rohamid/lcd-east-rising-backpack/lcd-bar-3_4/doc/lcd-bar-3_4.pdf

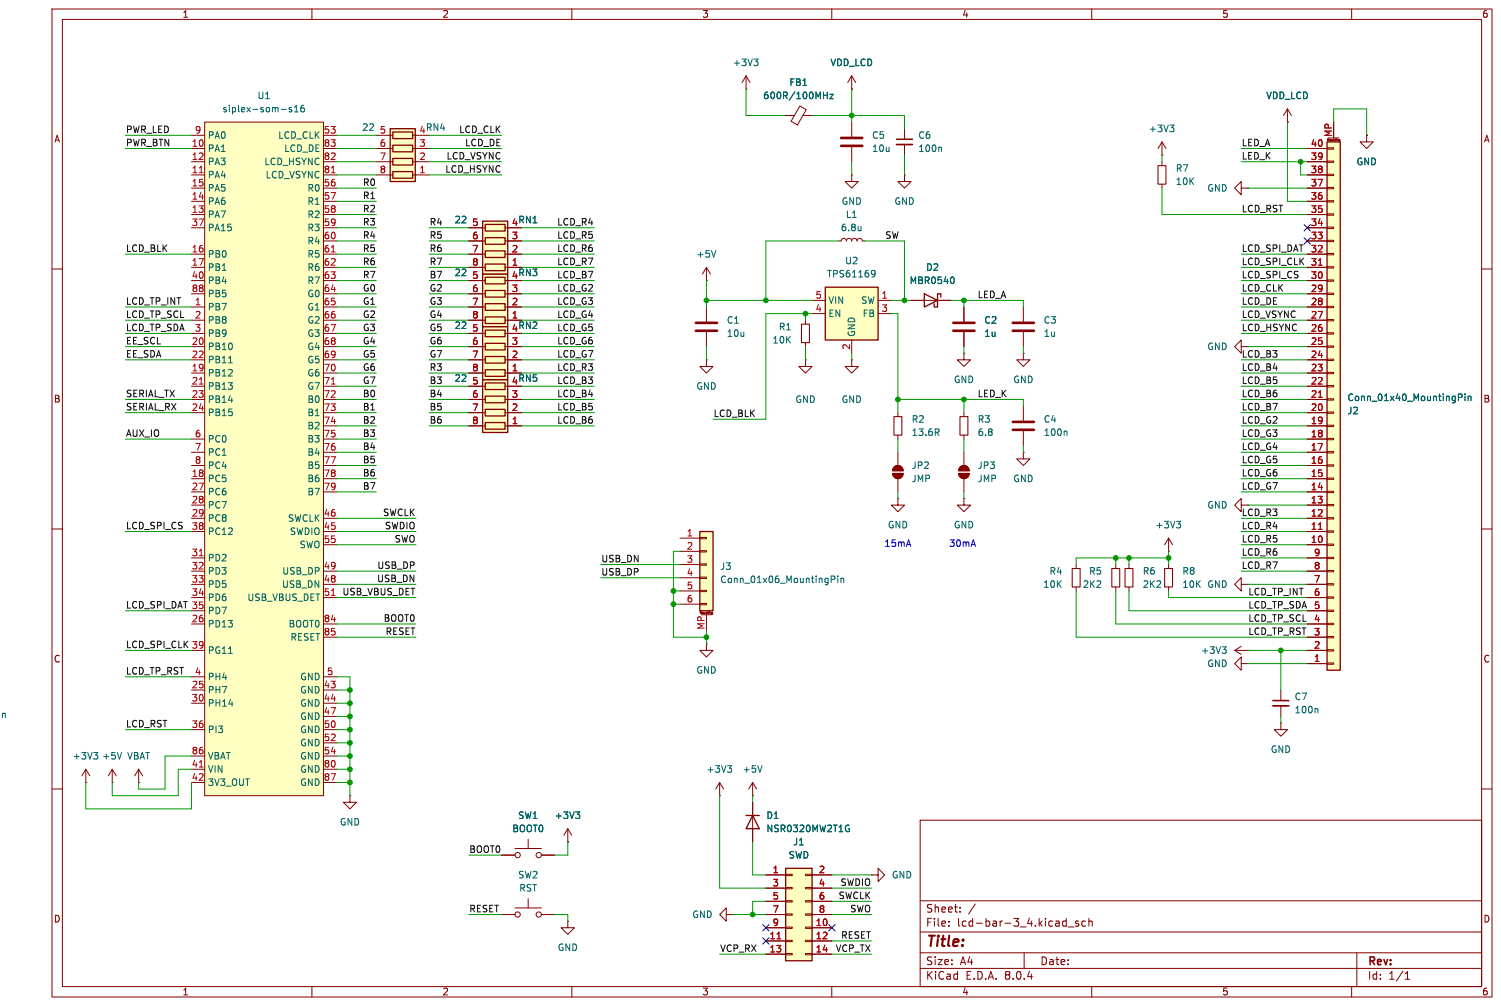
[picture p1: page 1]

Id: 1/1 Title: File: lcd-bar-3_4.kicad_sch Sheet: / D1 NSR0320MW2T1G
