rohamid/lcd-east-rising-backpack/lcd-standard-5R/lcd-standard-5R.kicad_pcb

## KiCad design lcd-standard-5R/lcd-standard-5R.kicad_pcb (2025-04-16)

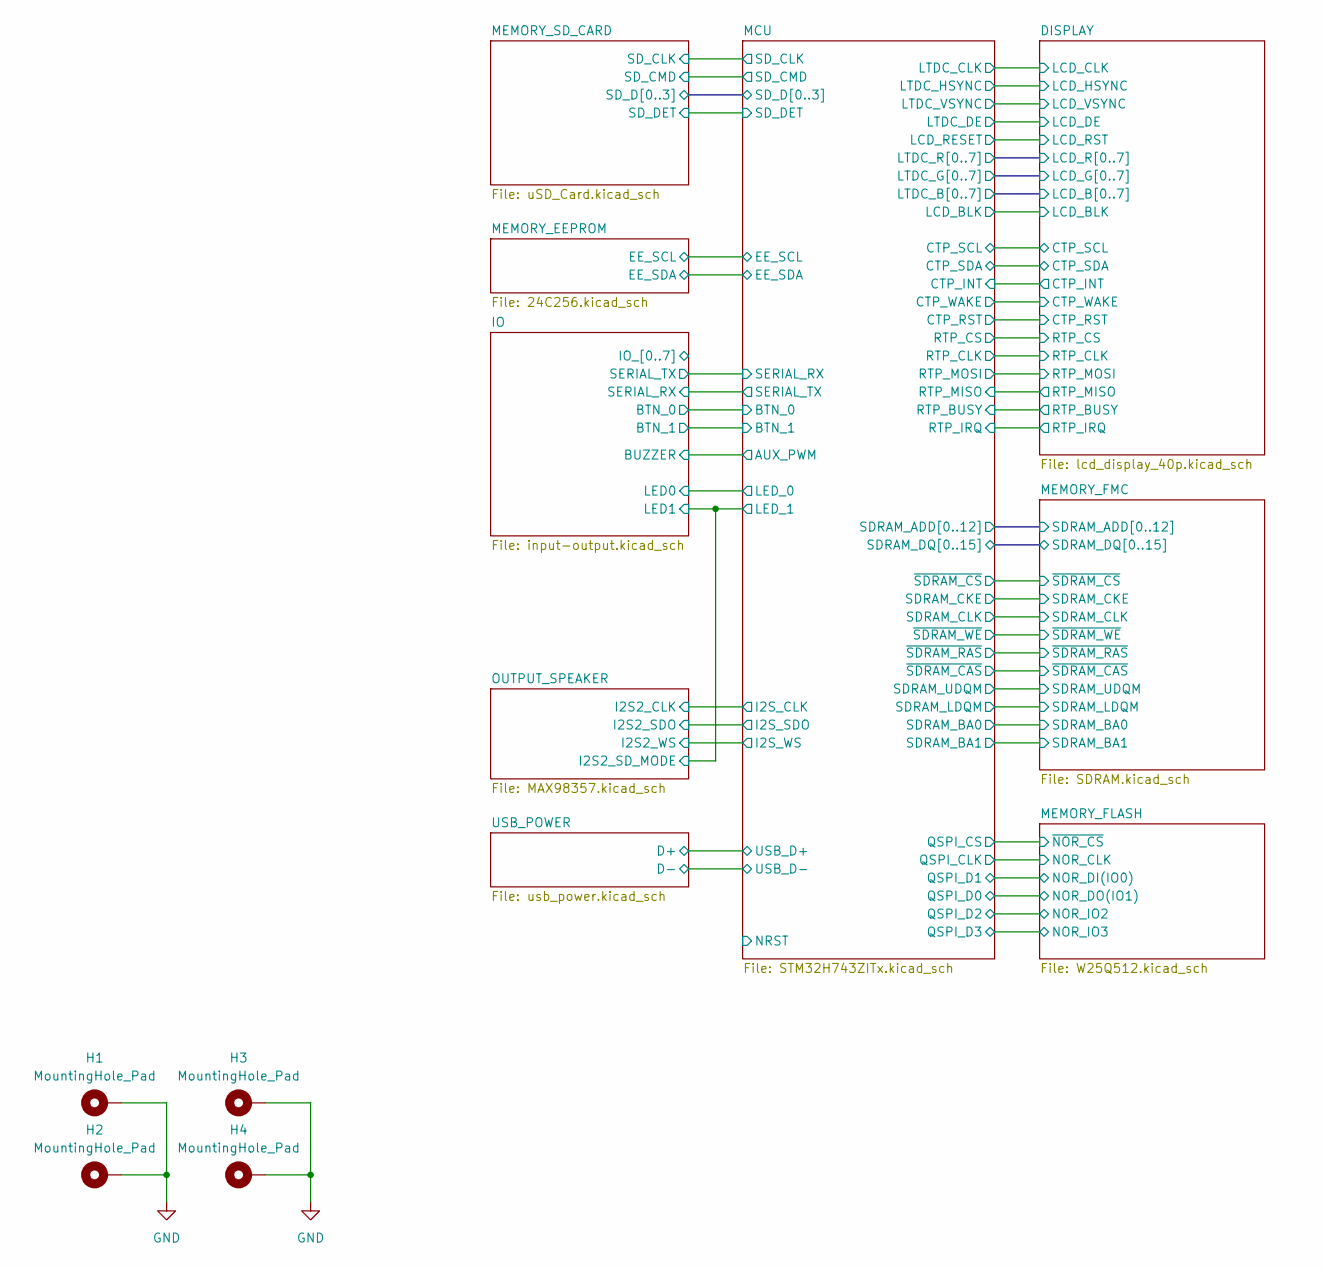
[picture p2: schematic lcd-standard-5R.kicad_sch]

Parts:
H1, H2, H3, H4: MountingHole_Pad; MountingHole_3.2mm_M3_Pad_Via

Connections:
GND: H1.1, H2.1, H3.1, H4.1; also elsewhere on the board

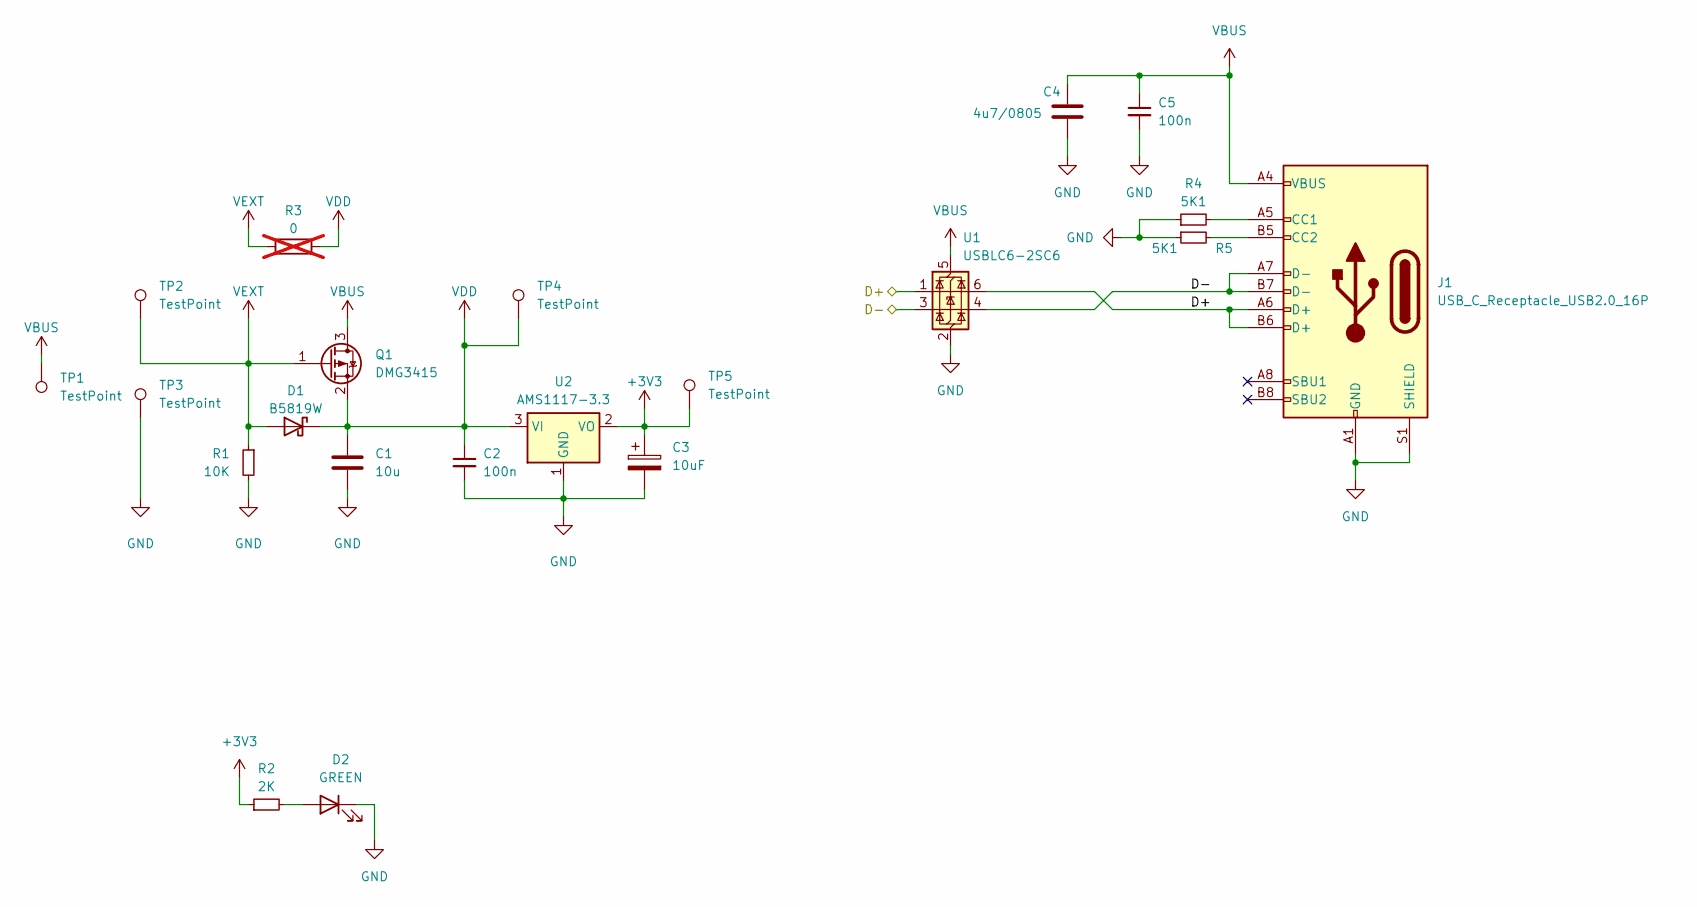
[picture p3: schematic usb_power.kicad_sch]

Parts:
C1: 10u; C_0805_2012Metric; JLCPCB Part # C15850
C2, C5: 100n; C_0402_1005Metric; JLCPCB Part # C307331
C3: 10uF; CP_EIA-3216-18_Kemet-A; JLCPCB Part # C7171
C4: 4u7/0805; C_0805_2012Metric; JLCPCB Part # C1779
D1: B5819W; D_SOD-123; JLCPCB Part # C7420330
D2: GREEN; LED_0805_2012Metric; JLCPCB Part # C2297
J1: USB_C_Receptacle_USB2.0_16P; USB_C_Receptacle_G-Switch_GT-USB-7010ASV; JLCPCB Part # C963412
Q1: DMG3415; SOT-23; JLCPCB Part # C7202986
R1: 10K; R_0402_1005Metric; JLCPCB Part # C25744
R2: 2K; R_0402_1005Metric; JLCPCB Part # C4109
R3: 0; R_1206_3216Metric; not fitted
R4, R5: 5K1; R_0402_1005Metric; JLCPCB Part # C25905
TP1, TP2, TP3, TP4, TP5: TestPoint; TestPoint_Pad_D1.0mm
U1: USBLC6-2SC6; SOT-23-6; JLCPCB Part # C2827654
U2: AMS1117-3.3; SOT-223-3_TabPin2; JLCPCB Part # C6186

Connections:
+3V3: C3.1, R2.1, TP5.1, U2.2 (VO); also elsewhere on the board
/USB_POWER/D+: J1.A6 (D+), J1.B6 (D+), U1.1 (I/O1), U1.6 (I/O1); also elsewhere on the board
/USB_POWER/D-: J1.A7 (D-), J1.B7 (D-), U1.3 (I/O2), U1.4 (I/O2); also elsewhere on the board
GND: C1.2, C2.2, C3.2, C4.2, C5.2, D2.1 (K), J1.A1 (GND), J1.A12 (GND), J1.B1 (GND), J1.B12 (GND), J1.S1 (SHIELD), R1.2, R4.1, R5.1, TP3.1, U1.2 (GND), U2.1 (GND); also elsewhere on the board
unnamed: D2.2 (A), R2.2
unnamed: J1.A5 (CC1), R4.2
unnamed: J1.B5 (CC2), R5.2
VBUS: C4.1, C5.1, J1.A4 (VBUS), J1.A9 (VBUS), J1.B4 (VBUS), J1.B9 (VBUS), Q1.3 (D), TP1.1, U1.5 (VBUS)
VDD: C1.1, C2.1, D1.1 (K), Q1.2 (S), R3.2, TP4.1, U2.3 (VI); also elsewhere on the board
VEXT: D1.2 (A), Q1.1 (G), R1.1, R3.1, TP2.1; also elsewhere on the board

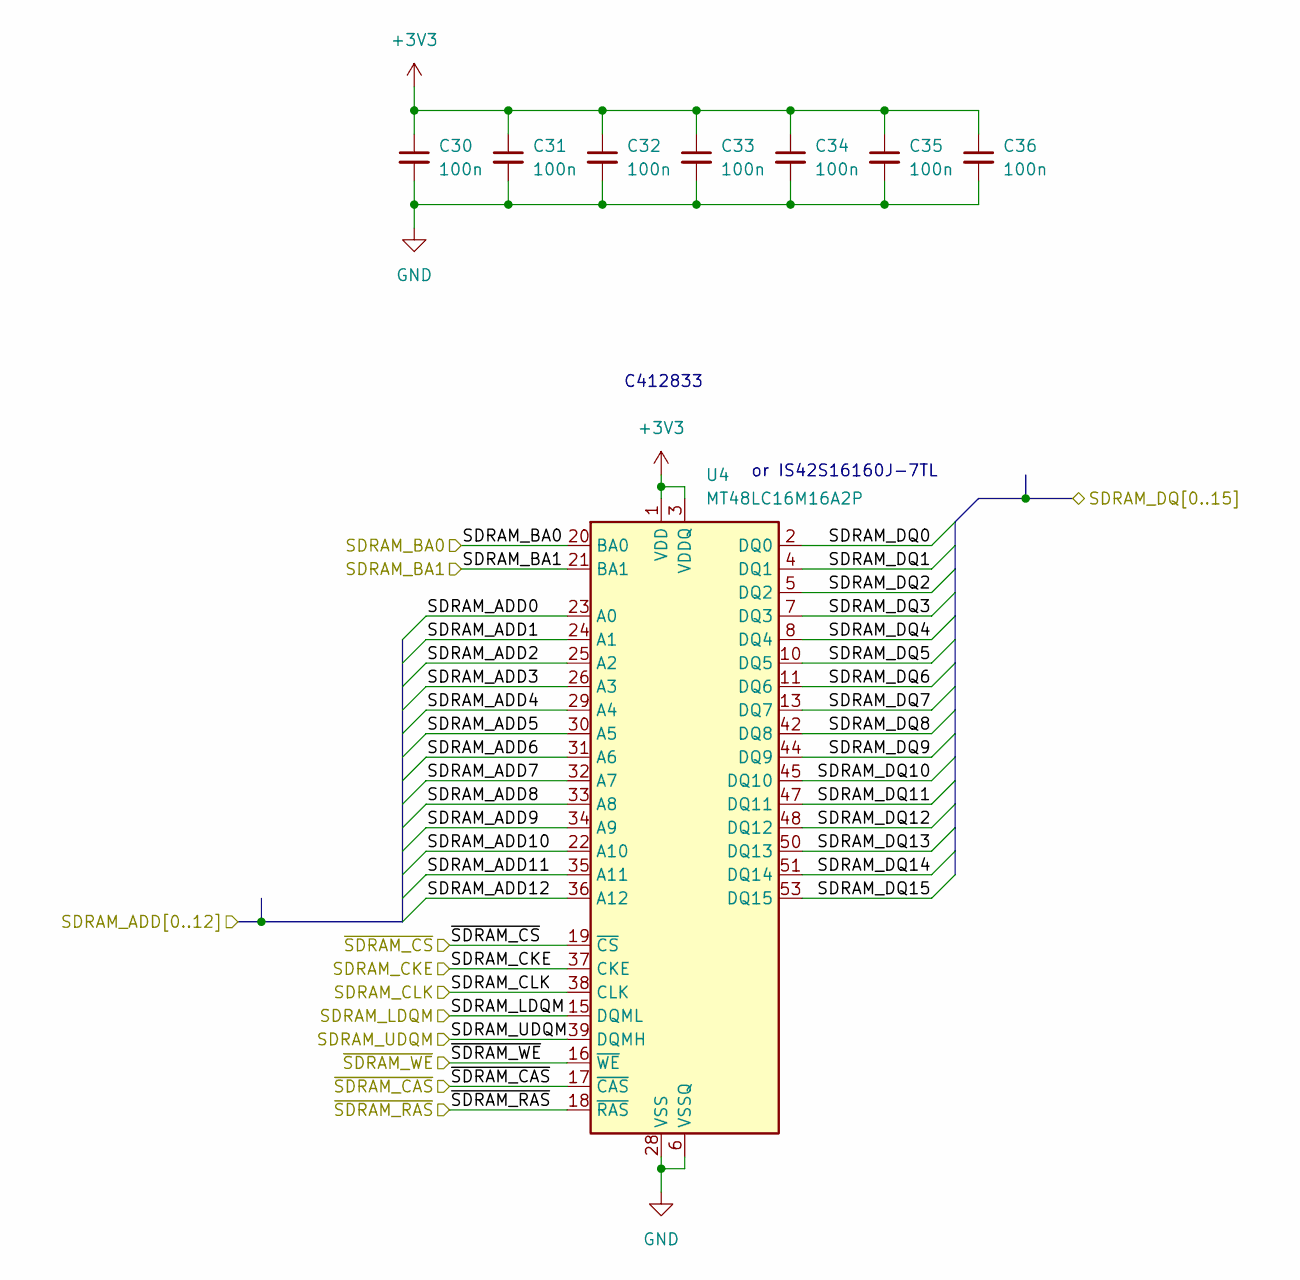
[picture p4: schematic SDRAM.kicad_sch]

Parts:
C30, C31, C32, C33, C34, C35, C36: 100n; C_0402_1005Metric; JLCPCB Part # C307331
U4: MT48LC16M16A2P; TSOP-II-54_22.2x10.16mm_P0.8mm; JLCPCB Part # C412833

Connections:
+3V3: C30.1, C31.1, C32.1, C33.1, C34.1, C35.1, C36.1, U4.1 (VDD), U4.3 (VDDQ), U4.9 (VDDQ), U4.14 (VDD), U4.27 (VDD), U4.43 (VDDQ), U4.49 (VDDQ); also elsewhere on the board
/MCU/SDRAM_ADD0: U4.23 (A0); also elsewhere on the board
/MCU/SDRAM_ADD1: U4.24 (A1); also elsewhere on the board
/MCU/SDRAM_ADD2: U4.25 (A2); also elsewhere on the board
/MCU/SDRAM_ADD3: U4.26 (A3); also elsewhere on the board
/MCU/SDRAM_ADD4: U4.29 (A4); also elsewhere on the board
/MCU/SDRAM_ADD5: U4.30 (A5); also elsewhere on the board
/MCU/SDRAM_ADD6: U4.31 (A6); also elsewhere on the board
/MCU/SDRAM_ADD7: U4.32 (A7); also elsewhere on the board
/MCU/SDRAM_ADD8: U4.33 (A8); also elsewhere on the board
/MCU/SDRAM_ADD9: U4.34 (A9); also elsewhere on the board
/MCU/SDRAM_ADD10: U4.22 (A10); also elsewhere on the board
/MCU/SDRAM_ADD11: U4.35 (A11); also elsewhere on the board
/MCU/SDRAM_ADD12: U4.36 (A12); also elsewhere on the board
/MCU/SDRAM_DQ0: U4.2 (DQ0); also elsewhere on the board
/MCU/SDRAM_DQ1: U4.4 (DQ1); also elsewhere on the board
/MCU/SDRAM_DQ2: U4.5 (DQ2); also elsewhere on the board
/MCU/SDRAM_DQ3: U4.7 (DQ3); also elsewhere on the board
/MCU/SDRAM_DQ4: U4.8 (DQ4); also elsewhere on the board
/MCU/SDRAM_DQ5: U4.10 (DQ5); also elsewhere on the board
/MCU/SDRAM_DQ6: U4.11 (DQ6); also elsewhere on the board
/MCU/SDRAM_DQ7: U4.13 (DQ7); also elsewhere on the board
/MCU/SDRAM_DQ8: U4.42 (DQ8); also elsewhere on the board
/MCU/SDRAM_DQ9: U4.44 (DQ9); also elsewhere on the board
/MCU/SDRAM_DQ10: U4.45 (DQ10); also elsewhere on the board
/MCU/SDRAM_DQ11: U4.47 (DQ11); also elsewhere on the board
/MCU/SDRAM_DQ12: U4.48 (DQ12); also elsewhere on the board
/MCU/SDRAM_DQ13: U4.50 (DQ13); also elsewhere on the board
/MCU/SDRAM_DQ14: U4.51 (DQ14); also elsewhere on the board
/MCU/SDRAM_DQ15: U4.53 (DQ15); also elsewhere on the board
/MEMORY_FMC/SDRAM_BA0: U4.20 (BA0); also elsewhere on the board
/MEMORY_FMC/SDRAM_BA1: U4.21 (BA1); also elsewhere on the board
/MEMORY_FMC/SDRAM_CKE: U4.37 (CKE); also elsewhere on the board
/MEMORY_FMC/SDRAM_CLK: U4.38 (CLK); also elsewhere on the board
/MEMORY_FMC/SDRAM_LDQM: U4.15 (DQML); also elsewhere on the board
/MEMORY_FMC/SDRAM_UDQM: U4.39 (DQMH); also elsewhere on the board
/MEMORY_FMC/~SDRAM_CAS: U4.17 (~CAS); also elsewhere on the board
/MEMORY_FMC/~SDRAM_CS: U4.19 (~CS); also elsewhere on the board
/MEMORY_FMC/~SDRAM_RAS: U4.18 (~RAS); also elsewhere on the board
/MEMORY_FMC/~SDRAM_WE: U4.16 (~WE); also elsewhere on the board
GND: C30.2, C31.2, C32.2, C33.2, C34.2, C35.2, C36.2, U4.6 (VSSQ), U4.12 (VSSQ), U4.28 (VSS), U4.41 (VSS), U4.46 (VSSQ), U4.52 (VSSQ), U4.54 (VSS); also elsewhere on the board

Notes on the sheet:
C412833
or IS42S16160J-7TL

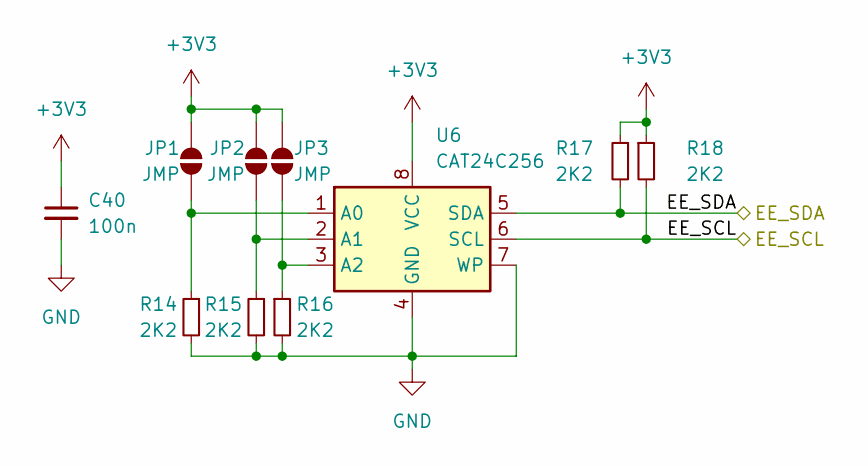
[picture p5: schematic 24C256.kicad_sch]

Parts:
C40: 100n; C_0402_1005Metric; JLCPCB Part # C307331
JP1, JP2, JP3: JMP; SolderJumper-2_P1.3mm_Open_RoundedPad1.0x1.5mm
R14, R15, R16, R17, R18: 2K2; R_0402_1005Metric; JLCPCB Part # C25879
U6: CAT24C256; SOIC-8_3.9x4.9mm_P1.27mm; JLCPCB Part # C6482

Connections:
+3V3: C40.1, JP1.2 (B), JP2.2 (B), JP3.2 (B), R17.1, R18.1, U6.8 (VCC); also elsewhere on the board
/MEMORY_EEPROM/EE_SCL: R18.2, U6.6 (SCL); also elsewhere on the board
/MEMORY_EEPROM/EE_SDA: R17.2, U6.5 (SDA); also elsewhere on the board
GND: C40.2, R14.2, R15.2, R16.2, U6.4 (GND), U6.7 (WP); also elsewhere on the board
unnamed: JP1.1 (A), R14.1, U6.1 (A0)
unnamed: JP2.1 (A), R15.1, U6.2 (A1)
unnamed: JP3.1 (A), R16.1, U6.3 (A2)

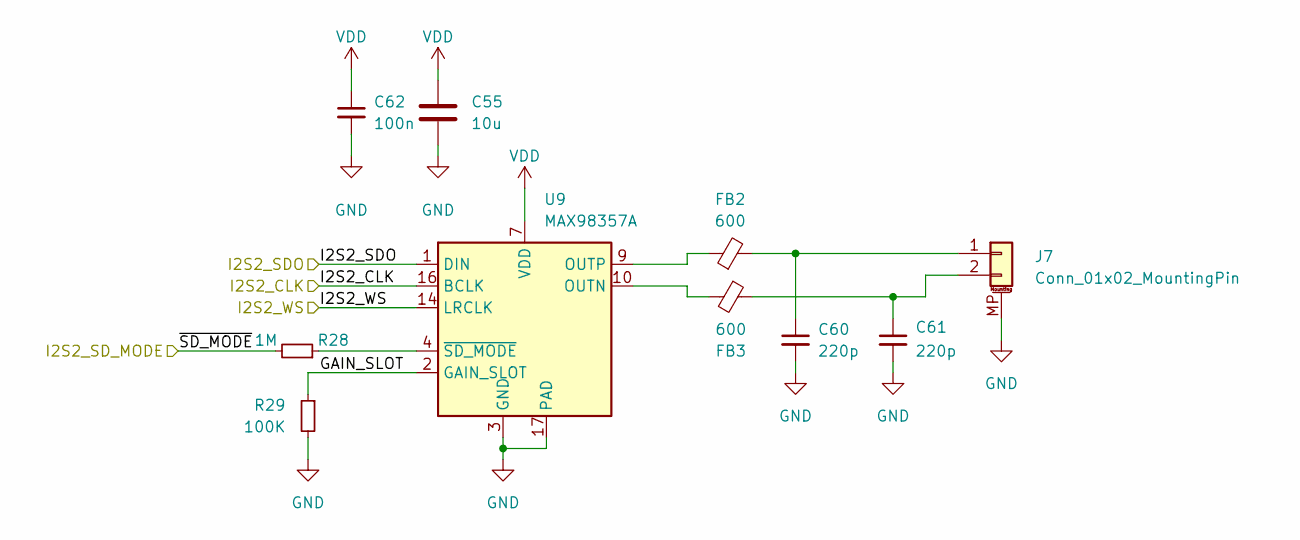
[picture p6: schematic MAX98357.kicad_sch]

Parts:
C55: 10u; C_0805_2012Metric; JLCPCB Part # C15850
C60, C61: 220p; C_0805_2012Metric; JLCPCB Part # C107145
C62: 100n; C_0402_1005Metric; JLCPCB Part # C307331
FB2, FB3: 600; L_0805_2012Metric; JLCPCB Part # C1017
J7: Conn_01x02_MountingPin; Hirose_DF13C_CL535-0402-2-51_1x02-1MP_P1.25mm_Vertical; JLCPCB Part # C7419891
R28: 1M; R_0402_1005Metric; JLCPCB Part # C26083
R29: 100K; R_0402_1005Metric; JLCPCB Part # C25741
U9: MAX98357A; TQFN-16-1EP_3x3mm_P0.5mm_EP1.23x1.23mm; JLCPCB Part # C910544

Connections:
/OUTPUT_SPEAKER/GAIN_SLOT: R29.1, U9.2 (GAIN_SLOT)
/OUTPUT_SPEAKER/I2S2_CLK: U9.16 (BCLK); also elsewhere on the board
/OUTPUT_SPEAKER/I2S2_SDO: U9.1 (DIN); also elsewhere on the board
/OUTPUT_SPEAKER/I2S2_WS: U9.14 (LRCLK); also elsewhere on the board
/OUTPUT_SPEAKER/~SD_MODE: R28.2; also elsewhere on the board
GND: C55.2, C60.2, C61.2, C62.2, J7.MP (MountPin), R29.2, U9.3 (GND), U9.11 (GND), U9.15 (GND), U9.17 (PAD); also elsewhere on the board
unnamed: C60.1, FB2.2, J7.1
unnamed: C61.1, FB3.1, J7.2
unnamed: FB3.2, U9.10 (OUTN)
unnamed: FB2.1, U9.9 (OUTP)
unnamed: R28.1, U9.4 (~SD_MODE)
VDD: C55.1, C62.1, U9.7 (VDD), U9.8 (VDD); also elsewhere on the board

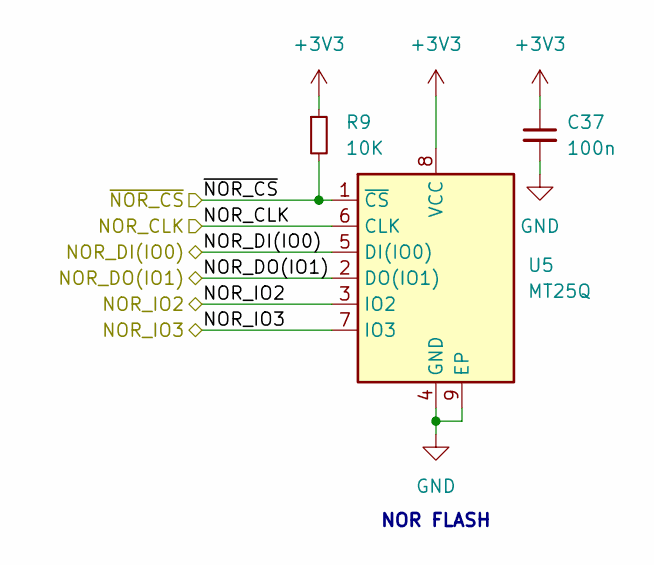
[picture p7: schematic W25Q512.kicad_sch]

Parts:
C37: 100n; C_0402_1005Metric; JLCPCB Part # C307331
R9: 10K; R_0402_1005Metric; JLCPCB Part # C25744
U5: MT25Q; WSON-8-1EP_8x6mm_P1.27mm_EP3.4x4.3mm; JLCPCB Part # C2061007

Connections:
+3V3: C37.1, R9.1, U5.8 (VCC); also elsewhere on the board
/MEMORY_FLASH/NOR_CLK: U5.6 (CLK); also elsewhere on the board
/MEMORY_FLASH/NOR_DI(IO0): U5.5 (DI(IO0)); also elsewhere on the board
/MEMORY_FLASH/NOR_DO(IO1): U5.2 (DO(IO1)); also elsewhere on the board
/MEMORY_FLASH/NOR_IO2: U5.3 (IO2); also elsewhere on the board
/MEMORY_FLASH/NOR_IO3: U5.7 (IO3); also elsewhere on the board
/MEMORY_FLASH/~NOR_CS: R9.2, U5.1 (~CS); also elsewhere on the board
GND: C37.2, U5.4 (GND), U5.9 (EP); also elsewhere on the board

Notes on the sheet:
NOR FLASH

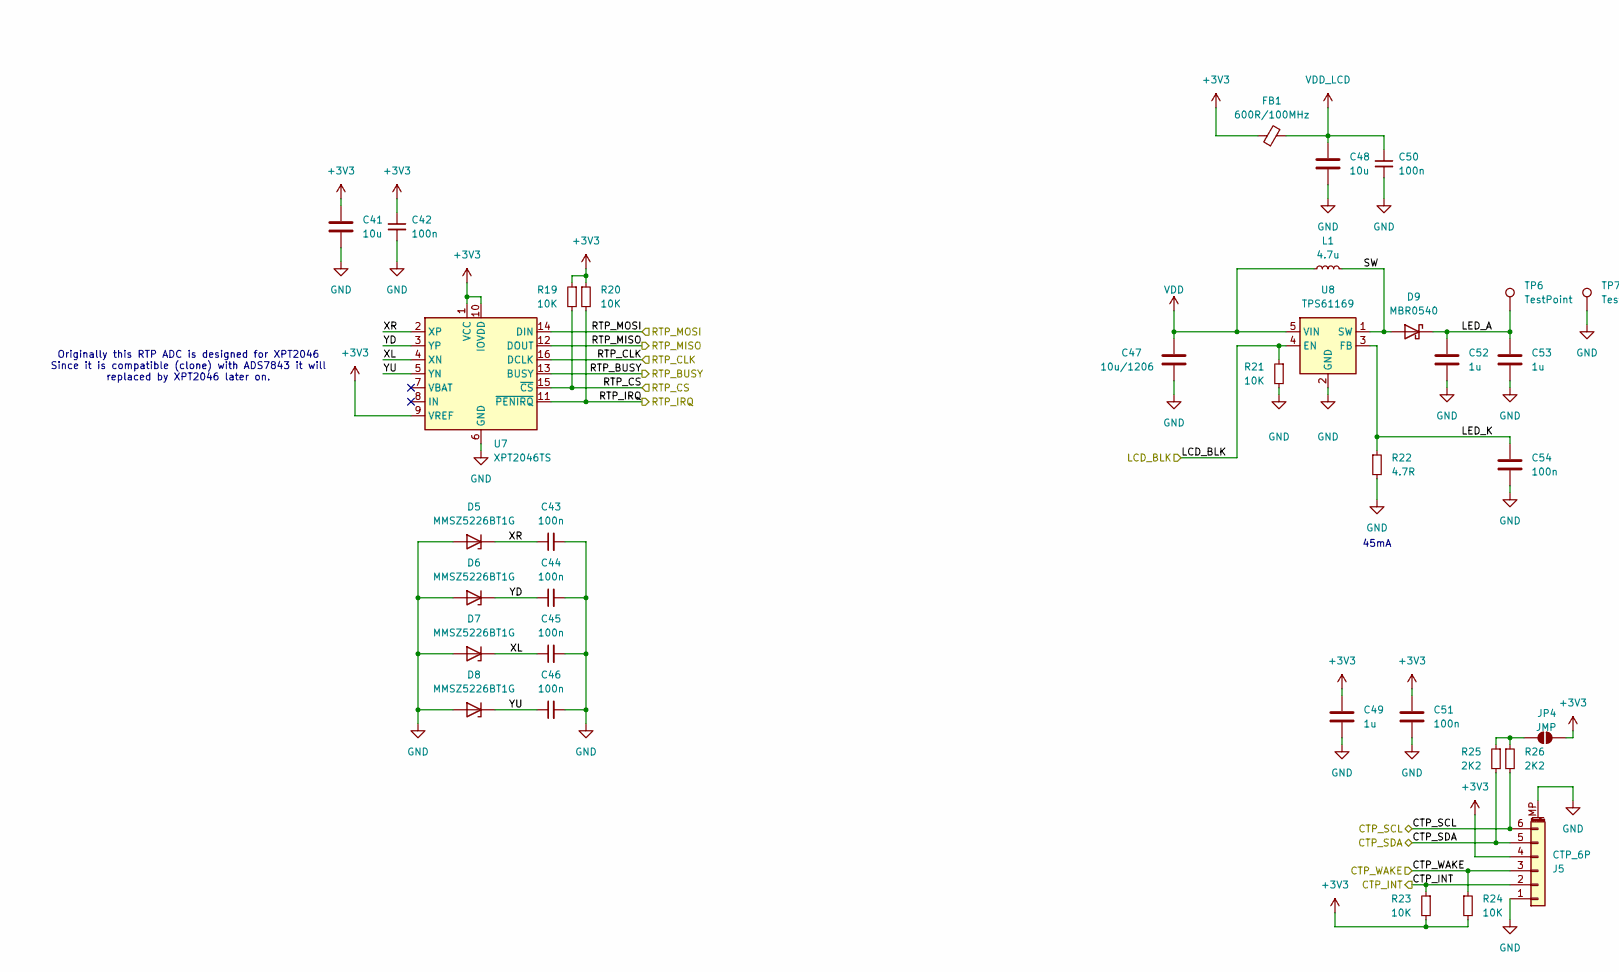
[picture p8: schematic lcd_display_40p.kicad_sch, part in row 1, column 1]

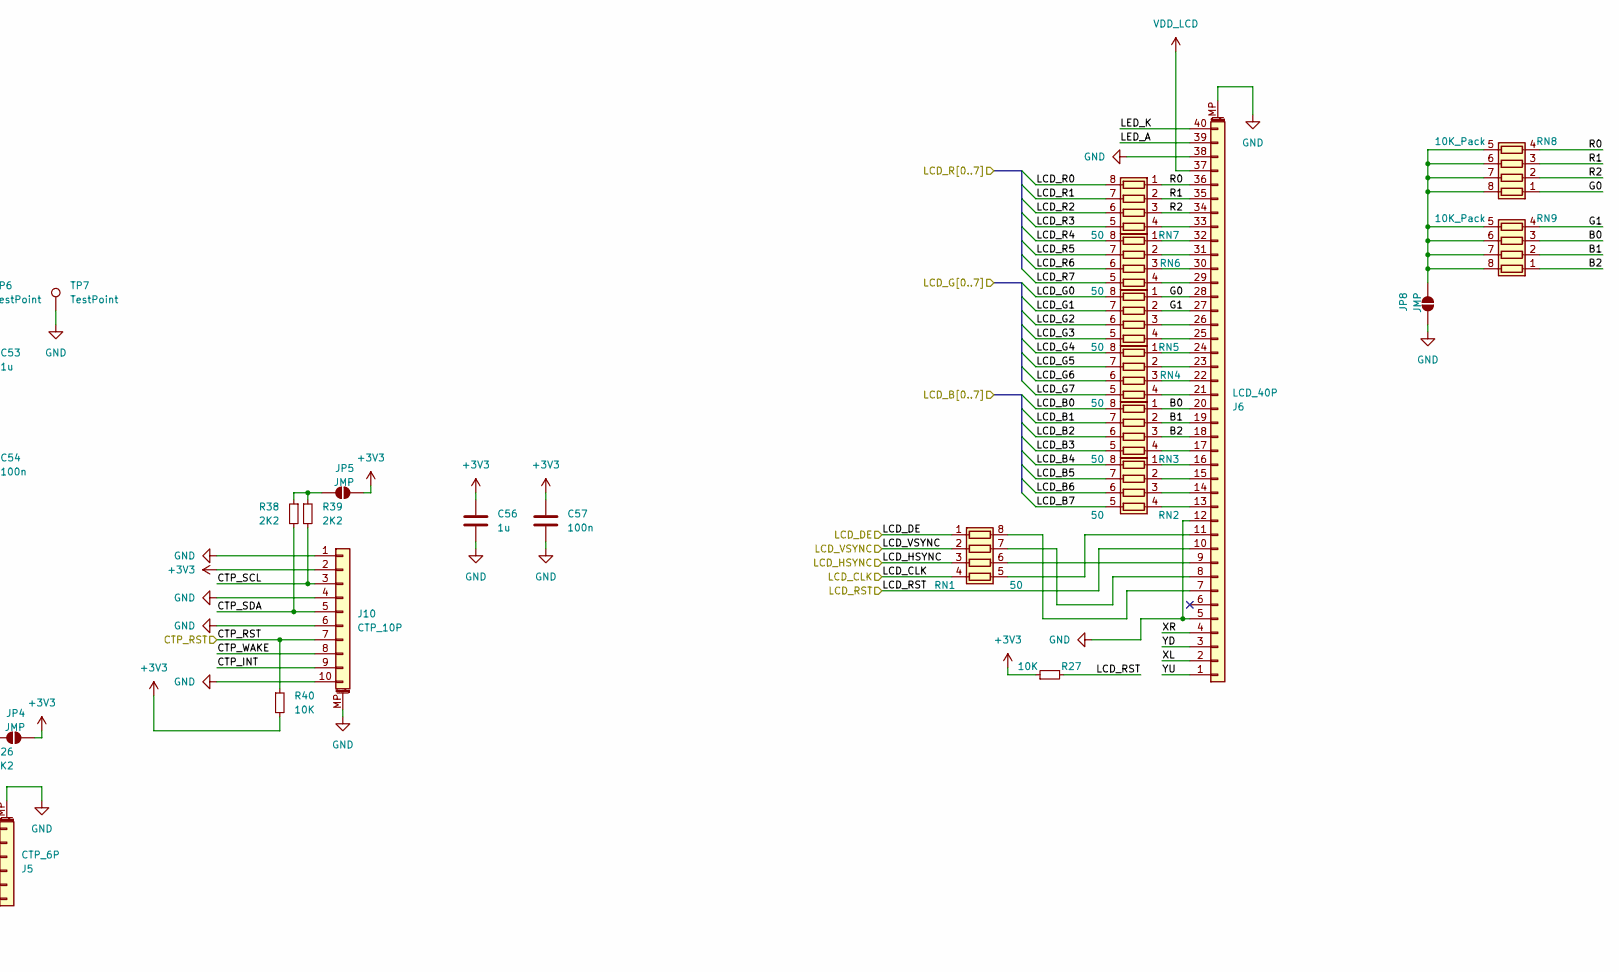
[picture p9: schematic lcd_display_40p.kicad_sch, part in row 1, column 2]

Parts:
C41, C48: 10u; C_0805_2012Metric; JLCPCB Part # C15850
C42, C43, C44, C45, C46, C50, C51, C54, C57: 100n; C_0402_1005Metric; JLCPCB Part # C307331
C47: 10u/1206; C_1206_3216Metric; JLCPCB Part # C13585
C49, C52, C53, C56: 1u; C_0603_1608Metric; JLCPCB Part # C15849
D5, D6, D7, D8: MMSZ5226BT1G; D_SOD-123; JLCPCB Part # C235771
D9: MBR0540; D_SOD-123; JLCPCB Part # C7420330
FB1: 600R/100MHz; C_0805_2012Metric; JLCPCB Part # C1017
J5: CTP_6P; Conn_FPC_6P_0.5mm_XUNPU_FPC-05FB-6PH20; JLCPCB Part # C2856827
J6: LCD_40P; Omron_XF2M-4015-1A_1x40-1MP_P0.5mm_Horizontal; JLCPCB Part # C225713
J10: CTP_10P; Conn_FPC_10P_0.5mm_OMRON_XF2M-1015-1A; JLCPCB Part # C271735
JP4, JP5, JP8: JMP; SolderJumper-2_P1.3mm_Open_RoundedPad1.0x1.5mm
L1: 4.7u; L_Abracon_ASPI-4030S; JLCPCB Part # C57269
R19, R20, R21, R23, R24, R27, R40: 10K; R_0402_1005Metric; JLCPCB Part # C25744
R22: 4.7R; R_0603_1608Metric; JLCPCB Part # C23164
R25, R26, R38, R39: 2K2; R_0402_1005Metric; JLCPCB Part # C25879
RN1, RN2, RN3, RN4, RN5, RN6, RN7: 50; R_Array_Convex_4x0402; JLCPCB Part # C48442
RN8, RN9: 10K_Pack; R_Array_Convex_4x0402; JLCPCB Part # C25725
TP6, TP7: TestPoint; TestPoint_Pad_D1.0mm
U7: XPT2046TS; TSSOP-16_4.4x5mm_P0.65mm; JLCPCB Part # C364888
U8: TPS61169; SOT-353_SC-70-5; JLCPCB Part # C71045

Connections:
+3V3: C41.1, C42.1, C49.1, C51.1, C56.1, C57.1, FB1.1, J5.4, J10.2, JP4.2 (B), JP5.2 (B), R19.1, R20.1, R23.2, R24.2, R27.1, R40.2, U7.1 (VCC), U7.9 (VREF), U7.10 (IOVDD); also elsewhere on the board
/DISPLAY/B0: J6.20, RN3.1 (R1.1), RN9.3 (R3.1)
/DISPLAY/B1: J6.19, RN3.2 (R2.1), RN9.2 (R2.1)
/DISPLAY/B2: J6.18, RN3.3 (R3.1), RN9.1 (R1.1)
/DISPLAY/CTP_INT: J5.2, J10.9, R23.1; also elsewhere on the board
/DISPLAY/CTP_RST: J10.7, R40.1; also elsewhere on the board
/DISPLAY/CTP_SCL: J5.6, J10.3, R26.2, R39.2; also elsewhere on the board
/DISPLAY/CTP_SDA: J5.5, J10.5, R25.2, R38.2; also elsewhere on the board
/DISPLAY/CTP_WAKE: J5.3, J10.8, R24.1; also elsewhere on the board
/DISPLAY/G0: J6.28, RN5.1 (R1.1), RN8.1 (R1.1)
/DISPLAY/G1: J6.27, RN5.2 (R2.1), RN9.4 (R4.1)
/DISPLAY/LCD_B0: RN3.8 (R1.2); also elsewhere on the board
/DISPLAY/LCD_B1: RN3.7 (R2.2); also elsewhere on the board
/DISPLAY/LCD_B2: RN3.6 (R3.2); also elsewhere on the board
/DISPLAY/LCD_B3: RN3.5 (R4.2); also elsewhere on the board
/DISPLAY/LCD_B4: RN2.8 (R1.2); also elsewhere on the board
/DISPLAY/LCD_B5: RN2.7 (R2.2); also elsewhere on the board
/DISPLAY/LCD_B6: RN2.6 (R3.2); also elsewhere on the board
/DISPLAY/LCD_B7: RN2.5 (R4.2); also elsewhere on the board
/DISPLAY/LCD_BLK: R21.1, U8.4 (EN); also elsewhere on the board
/DISPLAY/LCD_CLK: RN1.4 (R4.1); also elsewhere on the board
/DISPLAY/LCD_DE: RN1.1 (R1.1); also elsewhere on the board
/DISPLAY/LCD_G0: RN5.8 (R1.2); also elsewhere on the board
/DISPLAY/LCD_G1: RN5.7 (R2.2); also elsewhere on the board
/DISPLAY/LCD_G2: RN5.6 (R3.2); also elsewhere on the board
/DISPLAY/LCD_G3: RN5.5 (R4.2); also elsewhere on the board
/DISPLAY/LCD_G4: RN4.8 (R1.2); also elsewhere on the board
/DISPLAY/LCD_G5: RN4.7 (R2.2); also elsewhere on the board
/DISPLAY/LCD_G6: RN4.6 (R3.2); also elsewhere on the board
/DISPLAY/LCD_G7: RN4.5 (R4.2); also elsewhere on the board
/DISPLAY/LCD_HSYNC: RN1.3 (R3.1); also elsewhere on the board
/DISPLAY/LCD_R0: RN7.8 (R1.2); also elsewhere on the board
/DISPLAY/LCD_R1: RN7.7 (R2.2); also elsewhere on the board
/DISPLAY/LCD_R2: RN7.6 (R3.2); also elsewhere on the board
/DISPLAY/LCD_R3: RN7.5 (R4.2); also elsewhere on the board
/DISPLAY/LCD_R4: RN6.8 (R1.2); also elsewhere on the board
/DISPLAY/LCD_R5: RN6.7 (R2.2); also elsewhere on the board
/DISPLAY/LCD_R6: RN6.6 (R3.2); also elsewhere on the board
/DISPLAY/LCD_R7: RN6.5 (R4.2); also elsewhere on the board
/DISPLAY/LCD_RST: J6.10, R27.2
/DISPLAY/LCD_VSYNC: RN1.2 (R2.1); also elsewhere on the board
/DISPLAY/LED_A: C52.1, C53.1, D9.1 (K), J6.39, TP6.1
/DISPLAY/LED_K: C54.1, J6.40, R22.1, U8.3 (FB)
/DISPLAY/R0: J6.36, RN7.1 (R1.1), RN8.4 (R4.1)
/DISPLAY/R1: J6.35, RN7.2 (R2.1), RN8.3 (R3.1)
/DISPLAY/R2: J6.34, RN7.3 (R3.1), RN8.2 (R2.1)
/DISPLAY/RTP_BUSY: U7.13 (BUSY); also elsewhere on the board
/DISPLAY/RTP_CLK: U7.16 (DCLK); also elsewhere on the board
/DISPLAY/RTP_CS: R19.2, U7.15 (~CS); also elsewhere on the board
/DISPLAY/RTP_IRQ: R20.2, U7.11 (~PENIRQ); also elsewhere on the board
/DISPLAY/RTP_MISO: U7.12 (DOUT); also elsewhere on the board
/DISPLAY/RTP_MOSI: U7.14 (DIN); also elsewhere on the board
/DISPLAY/SW: D9.2 (A), L1.2, U8.1 (SW)
/DISPLAY/XL: C45.1, D7.1 (K), J6.2, U7.4 (XN)
/DISPLAY/XR: C43.1, D5.1 (K), J6.4, U7.2 (XP)
/DISPLAY/YD: C44.1, D6.1 (K), J6.3, U7.3 (YP)
/DISPLAY/YU: C46.1, D8.1 (K), J6.1, U7.5 (YN)
GND: C41.2, C42.2, C43.2, C44.2, C45.2, C46.2, C47.2, C48.2, C49.2, C50.2, C51.2, C52.2, C53.2, C54.2, C56.2, C57.2, D5.2 (A), D6.2 (A), D7.2 (A), D8.2 (A), J5.1, J5.MP (MountPin), J6.5, J6.12, J6.38, J6.MP (MountPin), J10.1, J10.4, J10.6, J10.10, J10.MP (MountPin), JP8.1 (A), R21.2, R22.2, TP7.1, U7.6 (GND), U8.2 (GND); also elsewhere on the board
unnamed: J6.7, RN1.8 (R1.2)
unnamed: J6.8, RN1.7 (R2.2)
unnamed: J6.9, RN1.6 (R3.2)
unnamed: J6.11, RN1.5 (R4.2)
unnamed: J6.13, RN2.4 (R4.1)
unnamed: J6.14, RN2.3 (R3.1)
unnamed: J6.15, RN2.2 (R2.1)
unnamed: J6.16, RN2.1 (R1.1)
unnamed: J6.17, RN3.4 (R4.1)
unnamed: J6.21, RN4.4 (R4.1)
unnamed: J6.22, RN4.3 (R3.1)
unnamed: J6.23, RN4.2 (R2.1)
unnamed: J6.24, RN4.1 (R1.1)
unnamed: J6.25, RN5.4 (R4.1)
unnamed: J6.26, RN5.3 (R3.1)
unnamed: J6.29, RN6.4 (R4.1)
unnamed: J6.30, RN6.3 (R3.1)
unnamed: J6.31, RN6.2 (R2.1)
unnamed: J6.32, RN6.1 (R1.1)
unnamed: J6.33, RN7.4 (R4.1)
unnamed: JP4.1 (A), R25.1, R26.1
unnamed: JP5.1 (A), R38.1, R39.1
unnamed 181: JP8.2 (B), RN8.5 (R4.2), RN8.6 (R3.2), RN8.7 (R2.2), RN8.8 (R1.2), RN9.5 (R4.2), RN9.6 (R3.2), RN9.7 (R2.2), RN9.8 (R1.2); also elsewhere on the board
VDD: C47.1, L1.1, U8.5 (VIN); also elsewhere on the board
VDD_LCD: C48.1, C50.1, FB1.2, J6.37

Notes on the sheet:
Originally this RTP ADC is designed for XPT2046 Since it is compatible (clone) with ADS7843 it will replaced by XPT2046 later on.
45mA

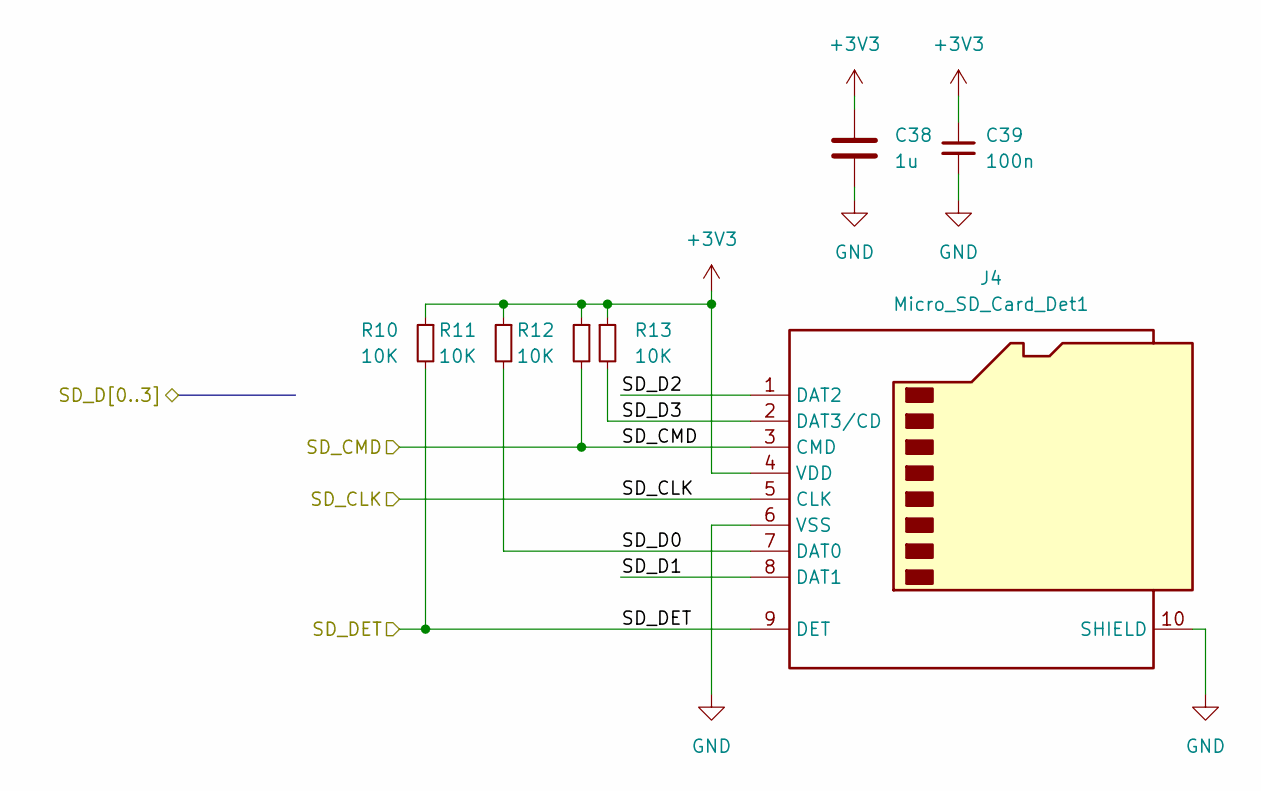
[picture p10: schematic uSD_Card.kicad_sch]

Parts:
C38: 1u; C_0603_1608Metric; JLCPCB Part # C15849
C39: 100n; C_0402_1005Metric; JLCPCB Part # C307331
J4: Micro_SD_Card_Det1; SD-TF-115; JLCPCB Part # C266621
R10, R11, R12, R13: 10K; R_0402_1005Metric; JLCPCB Part # C25744

Connections:
+3V3: C38.1, C39.1, J4.4 (VDD), R10.1, R11.1, R12.1, R13.1; also elsewhere on the board
/MCU/SD_D0: J4.7 (DAT0), R11.2; also elsewhere on the board
/MCU/SD_D1: J4.8 (DAT1); also elsewhere on the board
/MCU/SD_D2: J4.1 (DAT2); also elsewhere on the board
/MCU/SD_D3: J4.2 (DAT3/CD), R13.2; also elsewhere on the board
/MEMORY_SD_CARD/SD_CLK: J4.5 (CLK); also elsewhere on the board
/MEMORY_SD_CARD/SD_CMD: J4.3 (CMD), R12.2; also elsewhere on the board
/MEMORY_SD_CARD/SD_DET: J4.9 (DET), R10.2; also elsewhere on the board
GND: C38.2, C39.2, J4.6 (VSS), J4.10 (SHIELD); also elsewhere on the board
