rohamid/lcd-east-rising-backpack/lcd-standard-5R/lcd-standard-5R.kicad_pcb

## KiCad design lcd-standard-5R/lcd-standard-5R.kicad_pcb (continued)

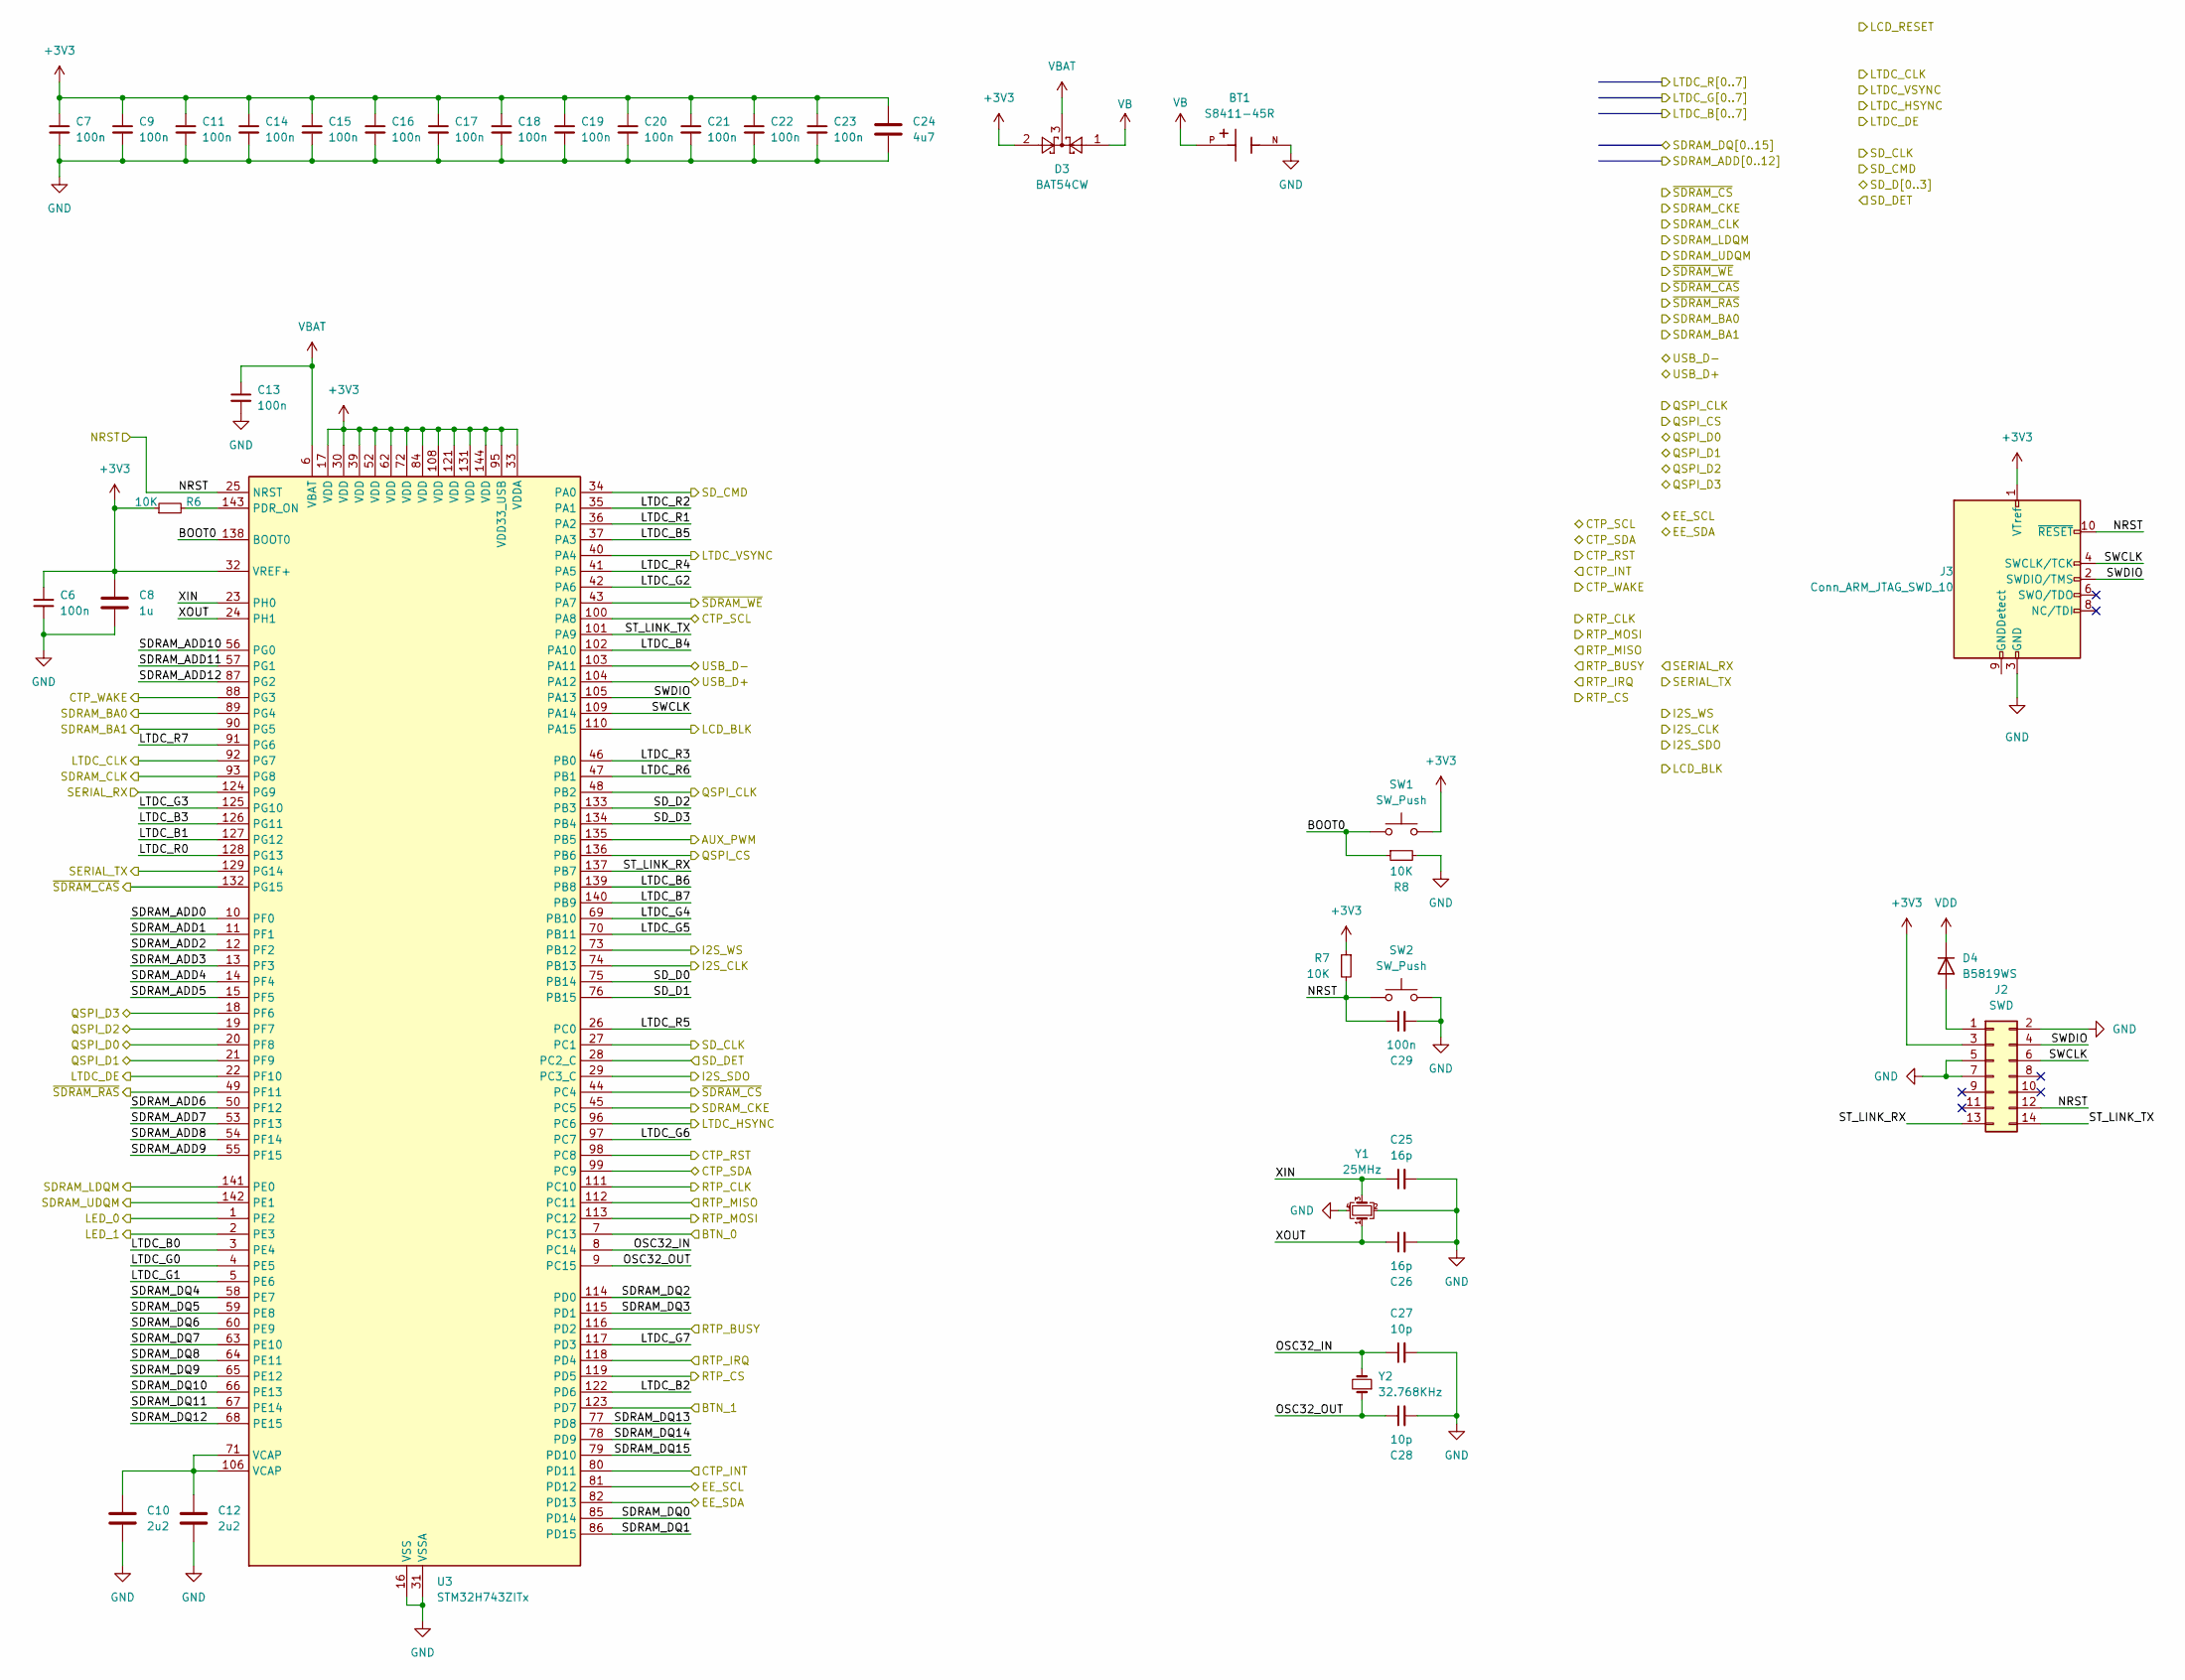
[picture p11: schematic STM32H743ZITx.kicad_sch]

Parts:
BT1: S8411-45R; CR1220-Batt-conn-S8411-45R; JLCPCB Part # C70381
C6, C7, C9, C11, C13, C14, C15, C16, C17, C18, C19, C20, C21, C22, C23, C29: 100n; C_0402_1005Metric; JLCPCB Part # C307331
C8: 1u; C_0603_1608Metric; JLCPCB Part # C15849
C10, C12: 2u2; C_0603_1608Metric; JLCPCB Part # C23630
C24: 4u7; C_0603_1608Metric; JLCPCB Part # C19666
C25, C26: 16p; C_0402_1005Metric; JLCPCB Part # C77590
C27, C28: 10p; C_0402_1005Metric; JLCPCB Part # C32949
D3: BAT54CW; SOT-23; JLCPCB Part # C37704
D4: B5819WS; D_SOD-123; JLCPCB Part # C8598
J2: SWD; PinHeader_2x07_P1.27mm_Vertical_SMD; JLCPCB Part # C5160763
J3: Conn_ARM_JTAG_SWD_10; Tag-Connect_TC2050-IDC-NL_2x05_P1.27mm_Vertical
R6, R7, R8: 10K; R_0402_1005Metric; JLCPCB Part # C25744
SW1, SW2: SW_Push; SW_SPST_PTS810; JLCPCB Part # C127488
U3: STM32H743ZITx; LQFP-144_20x20mm_P0.5mm; JLCPCB Part # C114408
Y1: 25MHz; Crystal_SMD_2520-4Pin_2.5x2.0mm; JLCPCB Part # C255954
Y2: 32.768KHz; Crystal_SMD_2012-2Pin_2.0x1.2mm; JLCPCB Part # C99009

Connections:
+3V3: C6.1, C7.1, C8.1, C9.1, C11.1, C14.1, C15.1, C16.1, C17.1, C18.1, C19.1, C20.1, C21.1, C22.1, C23.1, C24.1, D3.2, J2.3, J3.1 (VTref), R6.1, R7.1, SW1.2, U3.17 (VDD), U3.30 (VDD), U3.32 (VREF+), U3.33 (VDDA), U3.39 (VDD), U3.52 (VDD), U3.62 (VDD), U3.72 (VDD), U3.84 (VDD), U3.95 (VDD33_USB), U3.108 (VDD), U3.121 (VDD), U3.131 (VDD), U3.144 (VDD); also elsewhere on the board
/DISPLAY/CTP_INT: U3.80 (PD11); also elsewhere on the board
/DISPLAY/CTP_RST: U3.98 (PC8); also elsewhere on the board
/DISPLAY/CTP_SCL: U3.100 (PA8); also elsewhere on the board
/DISPLAY/CTP_SDA: U3.99 (PC9); also elsewhere on the board
/DISPLAY/CTP_WAKE: U3.88 (PG3); also elsewhere on the board
/DISPLAY/LCD_B0: U3.3 (PE4); also elsewhere on the board
/DISPLAY/LCD_B1: U3.127 (PG12); also elsewhere on the board
/DISPLAY/LCD_B2: U3.122 (PD6); also elsewhere on the board
/DISPLAY/LCD_B3: U3.126 (PG11); also elsewhere on the board
/DISPLAY/LCD_B4: U3.102 (PA10); also elsewhere on the board
/DISPLAY/LCD_B5: U3.37 (PA3); also elsewhere on the board
/DISPLAY/LCD_B6: U3.139 (PB8); also elsewhere on the board
/DISPLAY/LCD_B7: U3.140 (PB9); also elsewhere on the board
/DISPLAY/LCD_BLK: U3.110 (PA15); also elsewhere on the board
/DISPLAY/LCD_CLK: U3.92 (PG7); also elsewhere on the board
/DISPLAY/LCD_DE: U3.22 (PF10); also elsewhere on the board
/DISPLAY/LCD_G0: U3.4 (PE5); also elsewhere on the board
/DISPLAY/LCD_G1: U3.5 (PE6); also elsewhere on the board
/DISPLAY/LCD_G2: U3.42 (PA6); also elsewhere on the board
/DISPLAY/LCD_G3: U3.125 (PG10); also elsewhere on the board
/DISPLAY/LCD_G4: U3.69 (PB10); also elsewhere on the board
/DISPLAY/LCD_G5: U3.70 (PB11); also elsewhere on the board
/DISPLAY/LCD_G6: U3.97 (PC7); also elsewhere on the board
/DISPLAY/LCD_G7: U3.117 (PD3); also elsewhere on the board
/DISPLAY/LCD_HSYNC: U3.96 (PC6); also elsewhere on the board
/DISPLAY/LCD_R0: U3.128 (PG13); also elsewhere on the board
/DISPLAY/LCD_R1: U3.36 (PA2); also elsewhere on the board
/DISPLAY/LCD_R2: U3.35 (PA1); also elsewhere on the board
/DISPLAY/LCD_R3: U3.46 (PB0); also elsewhere on the board
/DISPLAY/LCD_R4: U3.41 (PA5); also elsewhere on the board
/DISPLAY/LCD_R5: U3.26 (PC0); also elsewhere on the board
/DISPLAY/LCD_R6: U3.47 (PB1); also elsewhere on the board
/DISPLAY/LCD_R7: U3.91 (PG6); also elsewhere on the board
/DISPLAY/LCD_VSYNC: U3.40 (PA4); also elsewhere on the board
/DISPLAY/RTP_BUSY: U3.116 (PD2); also elsewhere on the board
/DISPLAY/RTP_CLK: U3.111 (PC10); also elsewhere on the board
/DISPLAY/RTP_CS: U3.119 (PD5); also elsewhere on the board
/DISPLAY/RTP_IRQ: U3.118 (PD4); also elsewhere on the board
/DISPLAY/RTP_MISO: U3.112 (PC11); also elsewhere on the board
/DISPLAY/RTP_MOSI: U3.113 (PC12); also elsewhere on the board
/IO/BTN_0: U3.7 (PC13); also elsewhere on the board
/IO/BTN_1: U3.123 (PD7); also elsewhere on the board
/IO/BUZZER: U3.135 (PB5); also elsewhere on the board
/IO/LED0: U3.1 (PE2); also elsewhere on the board
/IO/SERIAL_RX: U3.129 (PG14); also elsewhere on the board
/IO/SERIAL_TX: U3.124 (PG9); also elsewhere on the board
/MCU/BOOT0: R8.1, SW1.1, U3.138 (BOOT0)
/MCU/NRST: C29.1, J2.12, J3.10 (~RESET), R7.2, SW2.1, U3.25 (NRST)
/MCU/OSC32_IN: C27.1, U3.8 (PC14), Y2.2
/MCU/OSC32_OUT: C28.1, U3.9 (PC15), Y2.1
/MCU/SDRAM_ADD0: U3.10 (PF0); also elsewhere on the board
/MCU/SDRAM_ADD1: U3.11 (PF1); also elsewhere on the board
/MCU/SDRAM_ADD2: U3.12 (PF2); also elsewhere on the board
/MCU/SDRAM_ADD3: U3.13 (PF3); also elsewhere on the board
/MCU/SDRAM_ADD4: U3.14 (PF4); also elsewhere on the board
/MCU/SDRAM_ADD5: U3.15 (PF5); also elsewhere on the board
/MCU/SDRAM_ADD6: U3.50 (PF12); also elsewhere on the board
/MCU/SDRAM_ADD7: U3.53 (PF13); also elsewhere on the board
/MCU/SDRAM_ADD8: U3.54 (PF14); also elsewhere on the board
/MCU/SDRAM_ADD9: U3.55 (PF15); also elsewhere on the board
/MCU/SDRAM_ADD10: U3.56 (PG0); also elsewhere on the board
/MCU/SDRAM_ADD11: U3.57 (PG1); also elsewhere on the board
/MCU/SDRAM_ADD12: U3.87 (PG2); also elsewhere on the board
/MCU/SDRAM_DQ0: U3.85 (PD14); also elsewhere on the board
/MCU/SDRAM_DQ1: U3.86 (PD15); also elsewhere on the board
/MCU/SDRAM_DQ2: U3.114 (PD0); also elsewhere on the board
/MCU/SDRAM_DQ3: U3.115 (PD1); also elsewhere on the board
/MCU/SDRAM_DQ4: U3.58 (PE7); also elsewhere on the board
/MCU/SDRAM_DQ5: U3.59 (PE8); also elsewhere on the board
/MCU/SDRAM_DQ6: U3.60 (PE9); also elsewhere on the board
/MCU/SDRAM_DQ7: U3.63 (PE10); also elsewhere on the board
/MCU/SDRAM_DQ8: U3.64 (PE11); also elsewhere on the board
/MCU/SDRAM_DQ9: U3.65 (PE12); also elsewhere on the board
/MCU/SDRAM_DQ10: U3.66 (PE13); also elsewhere on the board
/MCU/SDRAM_DQ11: U3.67 (PE14); also elsewhere on the board
/MCU/SDRAM_DQ12: U3.68 (PE15); also elsewhere on the board
/MCU/SDRAM_DQ13: U3.77 (PD8); also elsewhere on the board
/MCU/SDRAM_DQ14: U3.78 (PD9); also elsewhere on the board
/MCU/SDRAM_DQ15: U3.79 (PD10); also elsewhere on the board
/MCU/SD_D0: U3.75 (PB14); also elsewhere on the board
/MCU/SD_D1: U3.76 (PB15); also elsewhere on the board
/MCU/SD_D2: U3.133 (PB3); also elsewhere on the board
/MCU/SD_D3: U3.134 (PB4); also elsewhere on the board
/MCU/ST_LINK_RX: J2.13, U3.137 (PB7)
/MCU/ST_LINK_TX: J2.14, U3.101 (PA9)
/MCU/SWCLK: J2.6, J3.4 (SWCLK/TCK), U3.109 (PA14)
/MCU/SWDIO: J2.4, J3.2 (SWDIO/TMS), U3.105 (PA13)
/MCU/XIN: C25.1, U3.23 (PH0), Y1.3
/MCU/XOUT: C26.1, U3.24 (PH1), Y1.1
/MEMORY_EEPROM/EE_SCL: U3.81 (PD12); also elsewhere on the board
/MEMORY_EEPROM/EE_SDA: U3.82 (PD13); also elsewhere on the board
/MEMORY_FLASH/NOR_CLK: U3.48 (PB2); also elsewhere on the board
/MEMORY_FLASH/NOR_DI(IO0): U3.21 (PF9); also elsewhere on the board
/MEMORY_FLASH/NOR_DO(IO1): U3.20 (PF8); also elsewhere on the board
/MEMORY_FLASH/NOR_IO2: U3.19 (PF7); also elsewhere on the board
/MEMORY_FLASH/NOR_IO3: U3.18 (PF6); also elsewhere on the board
/MEMORY_FLASH/~NOR_CS: U3.136 (PB6); also elsewhere on the board
/MEMORY_FMC/SDRAM_BA0: U3.89 (PG4); also elsewhere on the board
/MEMORY_FMC/SDRAM_BA1: U3.90 (PG5); also elsewhere on the board
/MEMORY_FMC/SDRAM_CKE: U3.45 (PC5); also elsewhere on the board
/MEMORY_FMC/SDRAM_CLK: U3.93 (PG8); also elsewhere on the board
/MEMORY_FMC/SDRAM_LDQM: U3.141 (PE0); also elsewhere on the board
/MEMORY_FMC/SDRAM_UDQM: U3.142 (PE1); also elsewhere on the board
/MEMORY_FMC/~SDRAM_CAS: U3.132 (PG15); also elsewhere on the board
/MEMORY_FMC/~SDRAM_CS: U3.44 (PC4); also elsewhere on the board
/MEMORY_FMC/~SDRAM_RAS: U3.49 (PF11); also elsewhere on the board
/MEMORY_FMC/~SDRAM_WE: U3.43 (PA7); also elsewhere on the board
/MEMORY_SD_CARD/SD_CLK: U3.27 (PC1); also elsewhere on the board
/MEMORY_SD_CARD/SD_CMD: U3.34 (PA0); also elsewhere on the board
/MEMORY_SD_CARD/SD_DET: U3.28 (PC2_C); also elsewhere on the board
/OUTPUT_SPEAKER/I2S2_CLK: U3.74 (PB13); also elsewhere on the board
/OUTPUT_SPEAKER/I2S2_SDO: U3.29 (PC3_C); also elsewhere on the board
/OUTPUT_SPEAKER/I2S2_WS: U3.73 (PB12); also elsewhere on the board
/OUTPUT_SPEAKER/~SD_MODE: U3.2 (PE3); also elsewhere on the board
/USB_POWER/D+: U3.104 (PA12); also elsewhere on the board
/USB_POWER/D-: U3.103 (PA11); also elsewhere on the board
GND: BT1.N, C6.2, C7.2, C8.2, C9.2, C10.2, C11.2, C12.2, C13.2, C14.2, C15.2, C16.2, C17.2, C18.2, C19.2, C20.2, C21.2, C22.2, C23.2, C24.2, C25.2, C26.2, C27.2, C28.2, C29.2, J2.2, J2.5, J2.7, J3.3 (GND), J3.5 (GND), R8.2, SW2.2, U3.16 (VSS), U3.31 (VSSA), U3.38 (VSS), U3.51 (VSS), U3.61 (VSS), U3.83 (VSS), U3.94 (VSS), U3.107 (VSS), U3.120 (VSS), U3.130 (VSS), Y1.2, Y1.4; also elsewhere on the board
unnamed: C10.1, C12.1, U3.71 (VCAP), U3.106 (VCAP)
unnamed: D4.2 (A), J2.1
unnamed: R6.2, U3.143 (PDR_ON)
VB: BT1.P, D3.1
VBAT: C13.1, D3.3, U3.6 (VBAT)
VDD: D4.1 (K); also elsewhere on the board

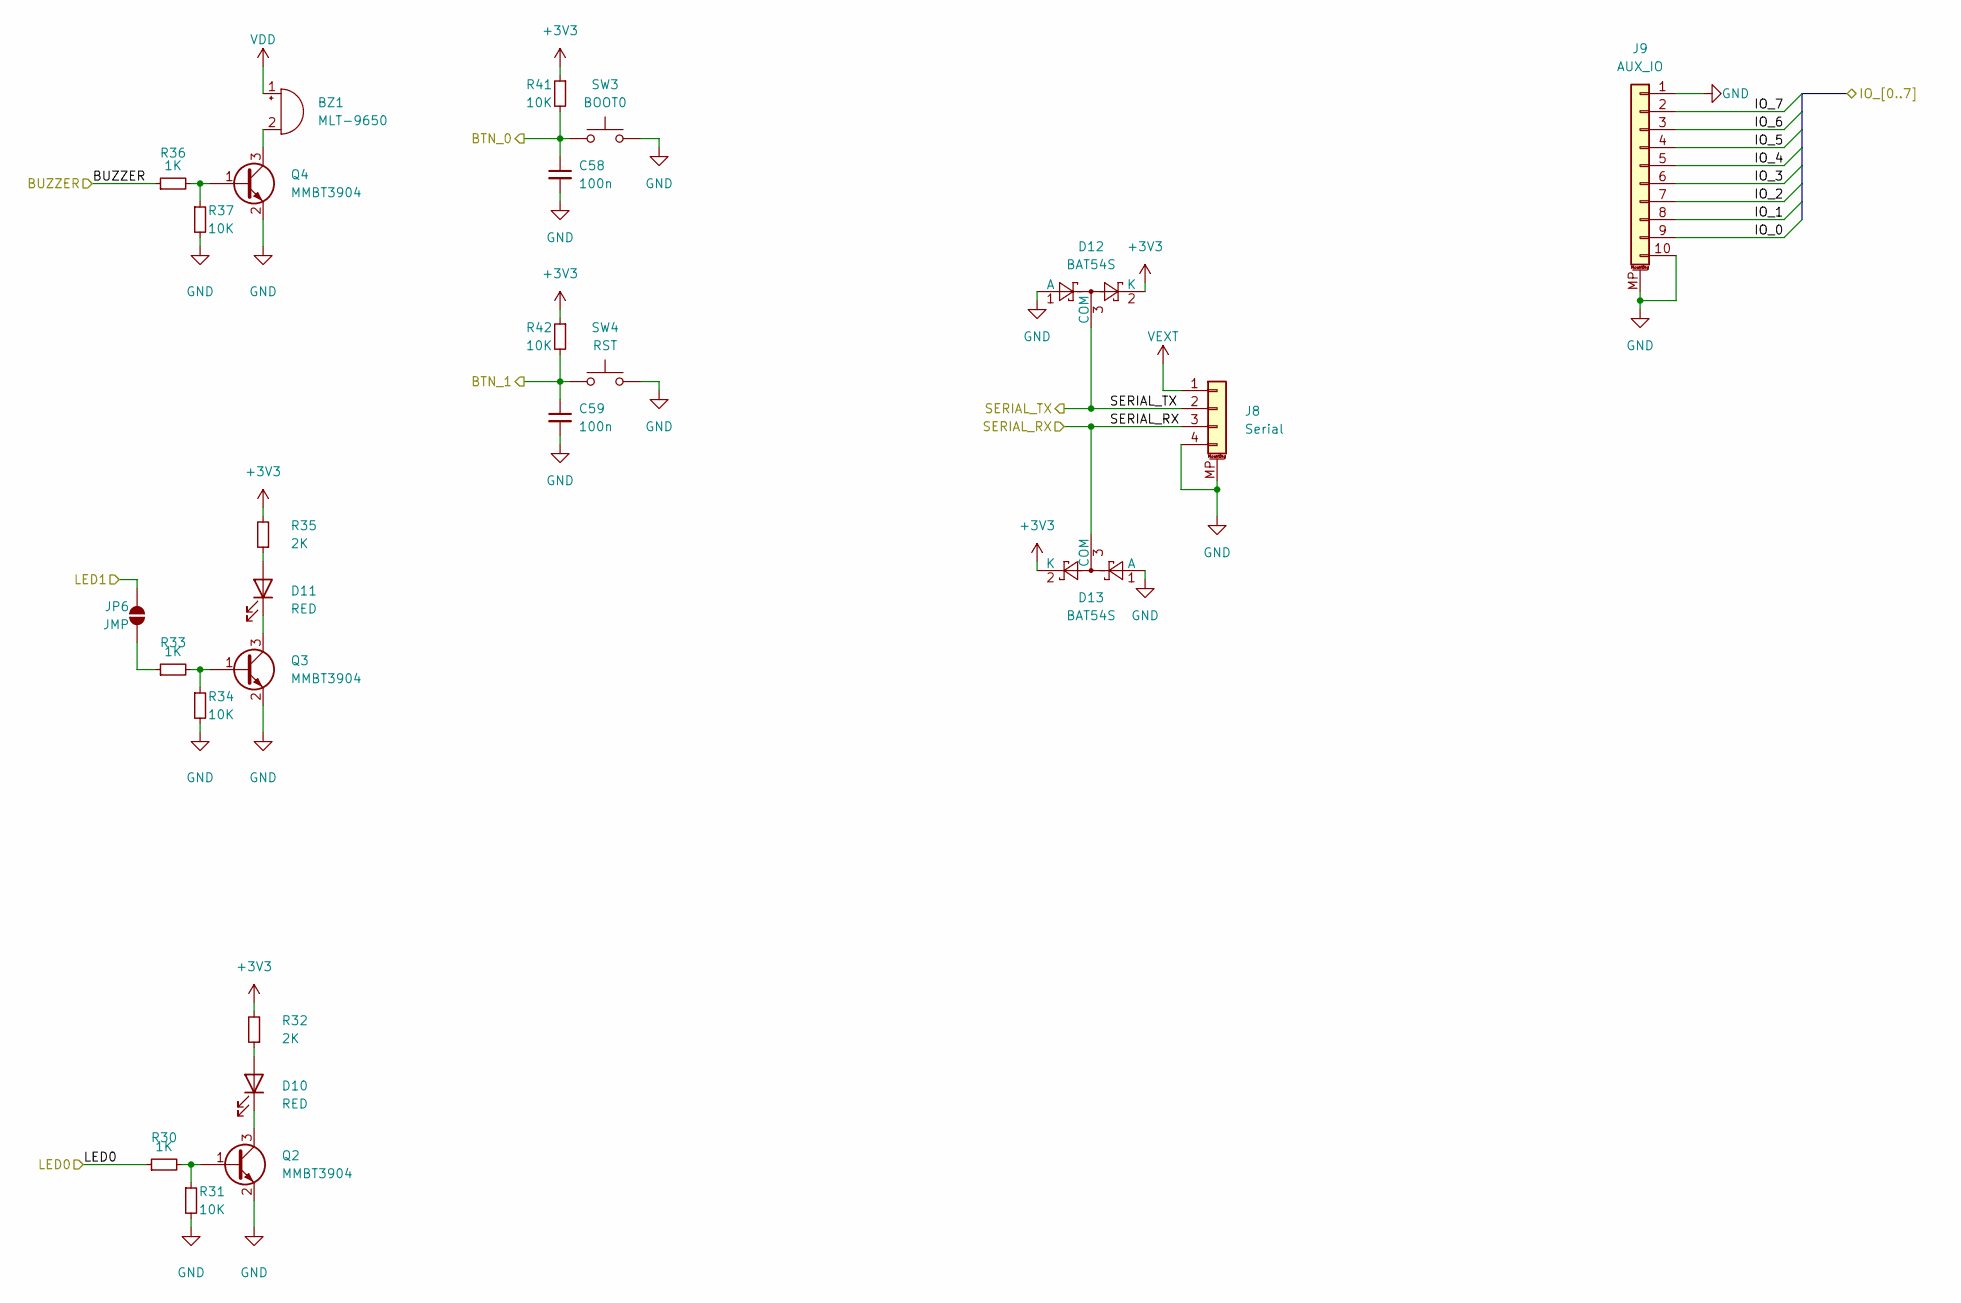
[picture p12: schematic input-output.kicad_sch]

Parts:
BZ1: MLT-9650; active-MLT-9650; JLCPCB Part # C255327
C58, C59: 100n; C_0402_1005Metric; JLCPCB Part # C307331
D10, D11: RED; LED_0805_2012Metric; JLCPCB Part # C84256
D12, D13: BAT54S; SOT-23; JLCPCB Part # C47546
J8: Serial; S4BXHSM4TBLFSN; JLCPCB Part # C146120
J9: AUX_IO; Conn_FPC_10P_1mm_G-SWITCH_GT-F1008SR20-10SMT01; JLCPCB Part # C22387155
JP6: JMP; SolderJumper-2_P1.3mm_Open_RoundedPad1.0x1.5mm
Q2, Q3, Q4: MMBT3904; SOT-23; JLCPCB Part # C7420353
R30, R33, R36: 1K; R_0402_1005Metric; JLCPCB Part # C11702
R31, R34, R37, R41, R42: 10K; R_0402_1005Metric; JLCPCB Part # C25744
R32, R35: 2K; R_0402_1005Metric; JLCPCB Part # C4109
SW3: BOOT0; SW_SPST_PTS810; JLCPCB Part # C127488
SW4: RST; SW_SPST_PTS810; JLCPCB Part # C127488

Connections:
+3V3: D12.2 (K), D13.2 (K), R32.2, R35.2, R41.1, R42.1; also elsewhere on the board
/IO/BTN_0: C58.1, R41.2, SW3.1; also elsewhere on the board
/IO/BTN_1: C59.1, R42.2, SW4.1; also elsewhere on the board
/IO/BUZZER: R36.1; also elsewhere on the board
/IO/IO_0: J9.9
/IO/IO_1: J9.8
/IO/IO_2: J9.7
/IO/IO_3: J9.6
/IO/IO_4: J9.5
/IO/IO_5: J9.4
/IO/IO_6: J9.3
/IO/IO_7: J9.2
/IO/LED0: R30.1; also elsewhere on the board
/IO/SERIAL_RX: D13.3 (COM), J8.3; also elsewhere on the board
/IO/SERIAL_TX: D12.3 (COM), J8.2; also elsewhere on the board
/OUTPUT_SPEAKER/~SD_MODE: JP6.2 (B); also elsewhere on the board
GND: C58.2, C59.2, D12.1 (A), D13.1 (A), J8.4, J8.MP (MountPin), J9.1, J9.10, J9.MP (MountPin), Q2.2 (E), Q3.2 (E), Q4.2 (E), R31.2, R34.2, R37.2, SW3.2, SW4.2; also elsewhere on the board
unnamed: BZ1.2 (-), Q4.3 (C)
unnamed: D10.2 (A), R32.1
unnamed: D10.1 (K), Q2.3 (C)
unnamed: D11.2 (A), R35.1
unnamed: D11.1 (K), Q3.3 (C)
unnamed: JP6.1 (A), R33.1
unnamed: Q2.1 (B), R30.2, R31.1
unnamed: Q3.1 (B), R33.2, R34.1
unnamed: Q4.1 (B), R36.2, R37.1
VDD: BZ1.1 (+); also elsewhere on the board
VEXT: J8.1; also elsewhere on the board

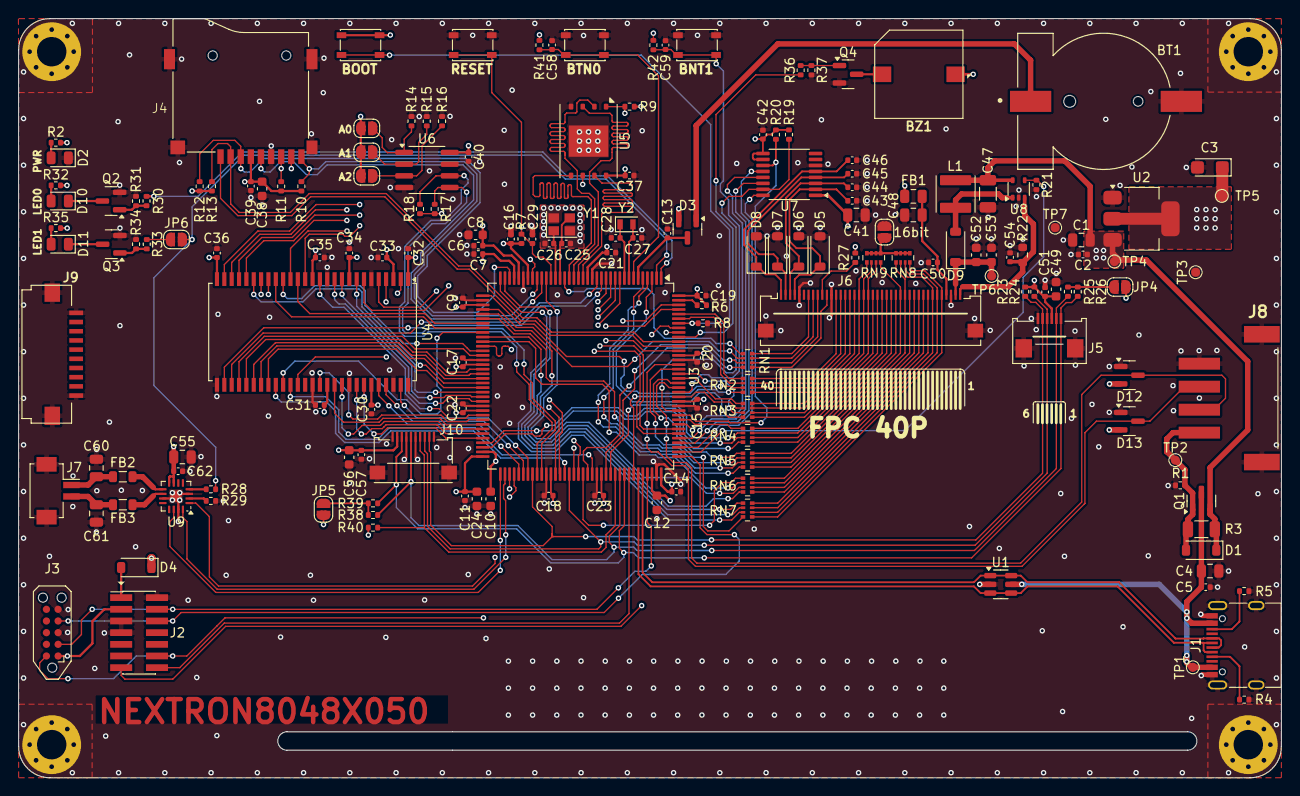
[picture p13: board lcd-standard-5R.kicad_pcb from above]

Board: 4 copper layers, 137.4 x 82.6 mm, 179 parts (0 on the bottom side), 187 nets.

Other parts of the board:
16bit: JMP; SolderJumper-2_P1.3mm_Open_RoundedPad1.0x1.5mm

Their connections:
GND: 16bit.1 (A); also elsewhere on the board
unnamed 181: 16bit.2 (B); also elsewhere on the board
