rohamid/lcd-east-rising-backpack/lcd-square-4inch/lcd-square-4inch.kicad_pcb

## KiCad design lcd-square-4inch/lcd-square-4inch.kicad_pcb (2025-04-16)

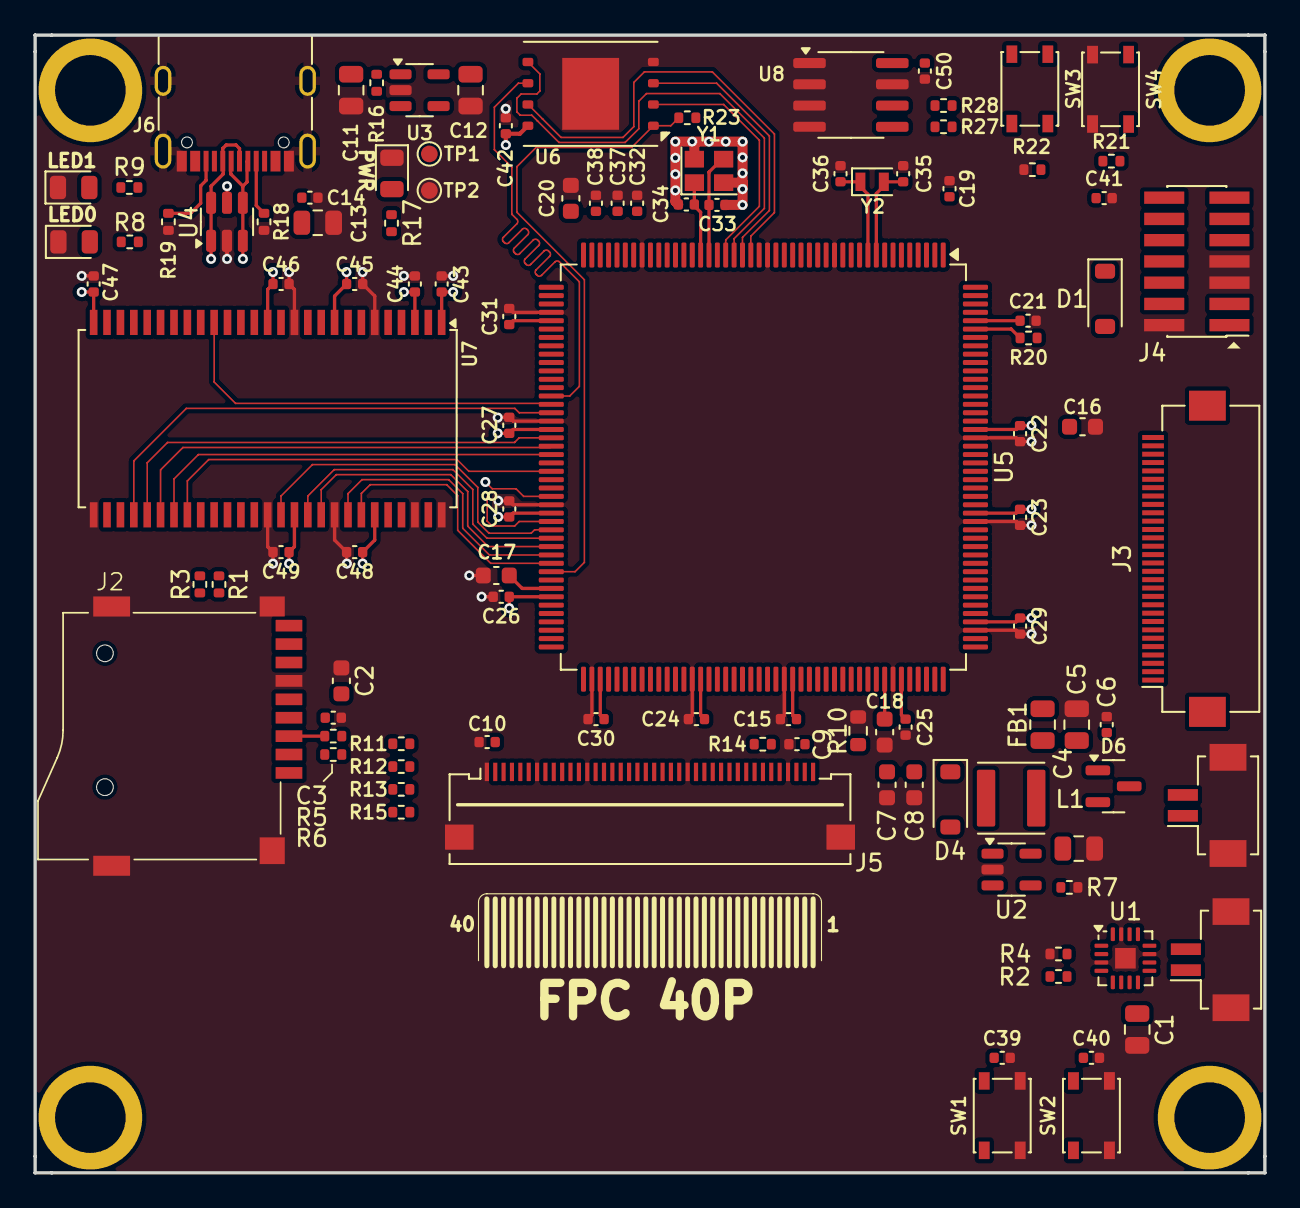
[picture p14: board lcd-square-4inch.kicad_pcb from above]

Board: 4 copper layers, 73.5 x 68.0 mm, 110 parts (0 on the bottom side), 89 nets.

Parts:
C1, C4, C5: 10u; C_0805_2012Metric
C2, C7, C8, C16: 1u; C_0603_1608Metric
C3, C6, C9, C10, C14, C15, C19, C21, C22, C23, C24, C25, C26, C27, C28, C29, C30, C31, C32, C37, C38, C39, C40, C41, C42, C43, C44, C45, C46, C47, C48, C49, C50: 100n; C_0402_1005Metric
C11: 1uF/0805; C_0805_2012Metric
C12: 2.2u; C_0805_2012Metric
C13: 4u7; C_0805_2012Metric
C17, C18: 2u2; C_0603_1608Metric
C20: 4u7; C_0603_1608Metric
C33, C34: 16p; C_0402_1005Metric
C35, C36: 10p; C_0402_1005Metric
D1: NSR0320MW2T1G; D_SOD-123
D2, D3: RED; LED_0805_2012Metric
D4: MBR0540; D_SOD-123
D5: GREEN; LED_0805_2012Metric
D6: BAT54CW; SOT-23
FB1: 600R/100MHz; C_0805_2012Metric
H1, H2, H3, H4: MountingHole; SMTSO30xx
J1, J1#2: Conn_01x02_MountingPin; Hirose_DF13C_CL535-0402-2-51_1x02-1MP_P1.25mm_Vertical
J2: Micro_SD_Card_Det1; SD-TF-115
J3: Conn_01x30_MountingPin; Hirose_FH12-30S-0.5SH_1x30-1MP_P0.50mm_Horizontal
J4: SWD; PinHeader_2x07_P1.27mm_Vertical_SMD
J5: Conn_01x40_MountingPin; Omron_XF2M-4015-1A_1x40-1MP_P0.5mm_Horizontal
J6: USB_C_Receptacle_USB2.0_16P; USB_C_Receptacle_G-Switch_GT-USB-7010ASV
L1: 4.7u; L_Abracon_ASPI-4030S
R1, R3, R5, R6, R7, R11, R14, R15, R16, R20, R21, R22, R23: 10K; R_0402_1005Metric
R2: 1M; R_0402_1005Metric
R4: 100K; R_0402_1005Metric
R8, R9: 2K; R_0402_1005Metric
R10: 6.8R; R_0603_1608Metric
R12, R13, R17, R27, R28: 2K2; R_0402_1005Metric
R18, R19: 5K1; R_0402_1005Metric
SW1, SW2, SW3, SW4: SW_Push; SW_SPST_PTS810
TP1, TP2: TestPoint; TestPoint_Pad_D1.0mm
U1: MAX98357A; TQFN-16-1EP_3x3mm_P0.5mm_EP1.23x1.23mm
U2: TPS61169; SOT-23-5
U3: TLV75733PDBV; SOT-23-5
U4: USBLC6-2SC6; SOT-23-6
U5: STM32H743IITx; LQFP-176_24x24mm_P0.5mm
U6: MT25Q; WSON-8-1EP_8x6mm_P1.27mm_EP3.4x4.3mm
U7: MT48LC16M16A2P; TSOP-II-54_22.2x10.16mm_P0.8mm
U8: CAT24C256; SOIC-8_3.9x4.9mm_P1.27mm
Y1: 25MHz; Crystal_SMD_2520-4Pin_2.5x2.0mm
Y2: 32.768KHz; Crystal_SMD_2012-2Pin_2.0x1.2mm

Connections:
+3V3: C2.1, C3.1, C10.1, C12.1, C15.1, C16.1, C20.1, C21.1, C22.1, C23.1, C24.1, C25.1, C26.1, C27.1, C28.1, C29.1, C30.1, C31.1, C32.1, C37.1, C38.1, C42.1, C43.1, C44.1, C45.1, C46.1, C47.1, C48.1, C49.1, C50.1, D6.2, FB1.1, J2.4 (VDD), J4.3, J5.2, R1.1, R3.1, R5.1, R6.1, R11.1, R12.1, R13.1, R14.1, R15.1, R17.1, R20.1, R21.1, R23.1, R27.1, R28.1, SW3.2, TP1.1, U3.5 (OUT), U5.15 (VDD), U5.23 (VDD), U5.36 (VDD), U5.38 (VREF+), U5.39 (VDDA), U5.49 (VDD), U5.62 (VDD), U5.72 (VDD), U5.82 (VDD), U5.91 (VDD), U5.103 (VDD), U5.114 (VDD33_USB), U5.127 (VDD), U5.136 (VDD), U5.149 (VDD), U5.159 (VDD), U5.172 (VDD), U6.8 (VCC), U7.1 (VDD), U7.3 (VDDQ), U7.9 (VDDQ), U7.14 (VDD), U7.27 (VDD), U7.43 (VDDQ), U7.49 (VDDQ), U8.8 (VCC)
/CMD: J2.3 (CMD), R5.2
/DAT0: J2.7 (DAT0), R3.2
/DAT3: J2.2 (DAT3/CD), R6.2
/EEPROM/EE_SCL: R28.2, U8.6 (SCL)
/EEPROM/EE_SDA: R27.2, U8.5 (SDA)
/LCD_BLK: R7.1, U2.4 (EN)
/LCD_RST: J5.35, R14.2
/LCD_TP_INT: J5.6, R15.2
/LCD_TP_RST: J5.3, R11.2
/LCD_TP_SCL: J5.4, R12.2
/LCD_TP_SDA: J5.5, R13.2
/LED_A: C7.1, C8.1, D4.1 (K), J5.40
/LED_K: C9.1, J5.38, J5.39, R10.1, U2.3 (FB)
/MCU/BOOT0: R22.1, SW3.1, U5.166 (BOOT0)
/MCU/BTN0: C40.1, SW2.1, U5.99 (PD11)
/MCU/BTN1: C39.1, SW1.1, U5.84 (PH7)
/MCU/NRST: C41.1, R21.2, SW4.1, U5.31 (NRST)
/MCU/OSC32_IN: C35.1, U5.9 (PC14), Y2.2
/MCU/OSC32_OUT: C36.1, U5.10 (PC15), Y2.1
/MCU/QUADSPI_BK1_IO0: U5.26 (PF8), U6.5 (DI(IO0))
/MCU/QUADSPI_BK1_IO1: U5.27 (PF9), U6.2 (DO(IO1))
/MCU/QUADSPI_BK1_IO2: U5.25 (PF7), U6.3 (IO2)
/MCU/QUADSPI_BK1_IO3: U5.24 (PF6), U6.7 (IO3)
/MCU/QUADSPI_BK1_NCS: R23.2, U5.79 (PB10), U6.1 (~CS)
/MCU/QUADSPI_CLK: U5.58 (PB2), U6.6 (CLK)
/MCU/SDRAM_ADD0: U5.16 (PF0), U7.23 (A0)
/MCU/SDRAM_ADD1: U5.17 (PF1), U7.24 (A1)
/MCU/SDRAM_ADD2: U5.18 (PF2), U7.25 (A2)
/MCU/SDRAM_ADD3: U5.19 (PF3), U7.26 (A3)
/MCU/SDRAM_ADD4: U5.20 (PF4), U7.29 (A4)
/MCU/SDRAM_ADD5: U5.21 (PF5), U7.30 (A5)
/MCU/SDRAM_ADD6: U5.60 (PF12), U7.31 (A6)
/MCU/SDRAM_ADD7: U5.63 (PF13), U7.32 (A7)
/MCU/SDRAM_ADD8: U5.64 (PF14), U7.33 (A8)
/MCU/SDRAM_ADD9: U5.65 (PF15), U7.34 (A9)
/MCU/SDRAM_ADD10: U5.66 (PG0), U7.22 (A10)
/MCU/SDRAM_ADD11: U5.67 (PG1), U7.35 (A11)
/MCU/SDRAM_ADD12: U5.106 (PG2), U7.36 (A12)
/MCU/SDRAM_DQ0: U5.104 (PD14), U7.2 (DQ0)
/MCU/SDRAM_DQ1: U5.105 (PD15), U7.4 (DQ1)
/MCU/SDRAM_DQ2: U5.142 (PD0), U7.5 (DQ2)
/MCU/SDRAM_DQ3: U5.143 (PD1), U7.7 (DQ3)
/MCU/SDRAM_DQ4: U5.68 (PE7), U7.8 (DQ4)
/MCU/SDRAM_DQ5: U5.69 (PE8), U7.10 (DQ5)
/MCU/SDRAM_DQ6: U5.70 (PE9), U7.11 (DQ6)
/MCU/SDRAM_DQ7: U5.73 (PE10), U7.13 (DQ7)
/MCU/SDRAM_DQ8: U5.74 (PE11), U7.42 (DQ8)
/MCU/SDRAM_DQ9: U5.75 (PE12), U7.44 (DQ9)
/MCU/SDRAM_DQ10: U5.76 (PE13), U7.45 (DQ10)
/MCU/SDRAM_DQ11: U5.77 (PE14), U7.47 (DQ11)
/MCU/SDRAM_DQ12: U5.78 (PE15), U7.48 (DQ12)
/MCU/SDRAM_DQ13: U5.96 (PD8), U7.50 (DQ13)
/MCU/SDRAM_DQ14: U5.97 (PD9), U7.51 (DQ14)
/MCU/SDRAM_DQ15: U5.98 (PD10), U7.53 (DQ15)
/MCU/XIN: C33.1, U5.29 (PH0), Y1.3
/MCU/XOUT: C34.1, U5.30 (PH1), Y1.1
/SDRAM/SDRAM_BA0: U5.108 (PG4), U7.20 (BA0)
/SDRAM/SDRAM_BA1: U5.109 (PG5), U7.21 (BA1)
/SDRAM/SDRAM_CKE: U5.55 (PC5), U7.37 (CKE)
/SDRAM/SDRAM_CLK: U5.112 (PG8), U7.38 (CLK)
/SDRAM/SDRAM_LDQM: U5.169 (PE0), U7.15 (DQML)
/SDRAM/SDRAM_UDQM: U5.170 (PE1), U7.39 (DQMH)
/SDRAM/~SDRAM_CAS: U5.160 (PG15), U7.17 (~CAS)
/SDRAM/~SDRAM_CS: U5.54 (PC4), U7.19 (~CS)
/SDRAM/~SDRAM_RAS: U5.59 (PF11), U7.18 (~RAS)
/SDRAM/~SDRAM_WE: U5.53 (PA7), U7.16 (~WE)
/SD_DET: J2.9 (DET), R1.2
/SW: D4.2 (A), L1.2, U2.1 (SW)
/USB_POWER/D+: J6.A6 (D+), J6.B6 (D+), U4.1 (I/O1), U4.6 (I/O1)
/USB_POWER/D-: J6.A7 (D-), J6.B7 (D-), U4.3 (I/O2), U4.4 (I/O2)
GND: C1.2, C2.2, C3.2, C4.2, C5.2, C6.2, C7.2, C8.2, C9.2, C10.2, C11.2, C12.2, C13.2, C14.2, C15.2, C16.2, C17.2, C18.2, C19.2, C20.2, C21.2, C22.2, C23.2, C24.2, C25.2, C26.2, C27.2, C28.2, C29.2, C30.2, C31.2, C32.2, C33.2, C34.2, C35.2, C36.2, C37.2, C38.2, C39.2, C40.2, C41.2, C42.2, C43.2, C44.2, C45.2, C46.2, C47.2, C48.2, C49.2, C50.2, D2.1 (K), D3.1 (K), D5.1 (K), J1.MP (MountPin), J1#2.MP (MountPin), J2.6 (VSS), J2.10 (SHIELD), J4.2, J4.5, J4.7, J5.1, J5.7, J5.13, J5.25, J5.37, J5.MP (MountPin), J6.A1 (GND), J6.A12 (GND), J6.B1 (GND), J6.B12 (GND), J6.S1 (SHIELD), R4.2, R7.2, R10.2, R18.1, R19.1, R22.2, SW1.2, SW2.2, SW4.2, TP2.1, U1.3 (GND), U1.11 (GND), U1.15 (GND), U1.17 (PAD), U2.2 (GND), U3.2 (GND), U4.2 (GND), U5.14 (VSS), U5.22 (VSS), U5.37 (VSSA), U5.48 (VSS), U5.61 (VSS), U5.71 (VSS), U5.90 (VSS), U5.102 (VSS), U5.113 (VSS), U5.126 (VSS), U5.135 (VSS), U5.148 (VSS), U5.158 (VSS), U6.4 (GND), U6.9 (EP), U7.6 (VSSQ), U7.12 (VSSQ), U7.28 (VSS), U7.41 (VSS), U7.46 (VSSQ), U7.52 (VSSQ), U7.54 (VSS), U8.1 (A0), U8.2 (A1), U8.3 (A2), U8.4 (GND), U8.7 (WP), Y1.2, Y1.4
unnamed: C17.1, C18.1, U5.81 (VCAP), U5.125 (VCAP)
unnamed: D1.2 (A), J4.1
unnamed: D2.2 (A), R8.2
unnamed: D3.2 (A), R9.2
unnamed: D5.2 (A), R17.2
unnamed: J1.1, J1#2.1, U1.9 (OUTP)
unnamed: J1.2, J1#2.2, U1.10 (OUTN)
unnamed: J6.A5 (CC1), R18.2
unnamed: J6.B5 (CC2), R19.2
unnamed: R4.1, U1.2 (GAIN_SLOT)
unnamed: R2.2, U1.4 (~SD_MODE)
unnamed: R16.2, U3.3 (EN)
unnamed: R20.2, U5.171 (PDR_ON)
VBAT: C19.1, D6.3, U5.6 (VBAT)
VBUS: C1.1, C4.1, C13.1, C14.1, D1.1 (K), J6.A4 (VBUS), J6.A9 (VBUS), J6.B4 (VBUS), J6.B9 (VBUS), L1.1, U1.7 (VDD), U1.8 (VDD), U2.5 (VIN), U4.5 (VBUS)
VDD: C11.1, R16.1, U3.1 (IN)
VDD_LCD: C5.1, C6.1, FB1.2, J5.36
