rohamid/lcd-east-rising-backpack/lcd-square-4-4848/lcd-square-4-4848.kicad_pcb

## KiCad design lcd-square-4-4848/lcd-square-4-4848.kicad_pcb (2025-01-03)

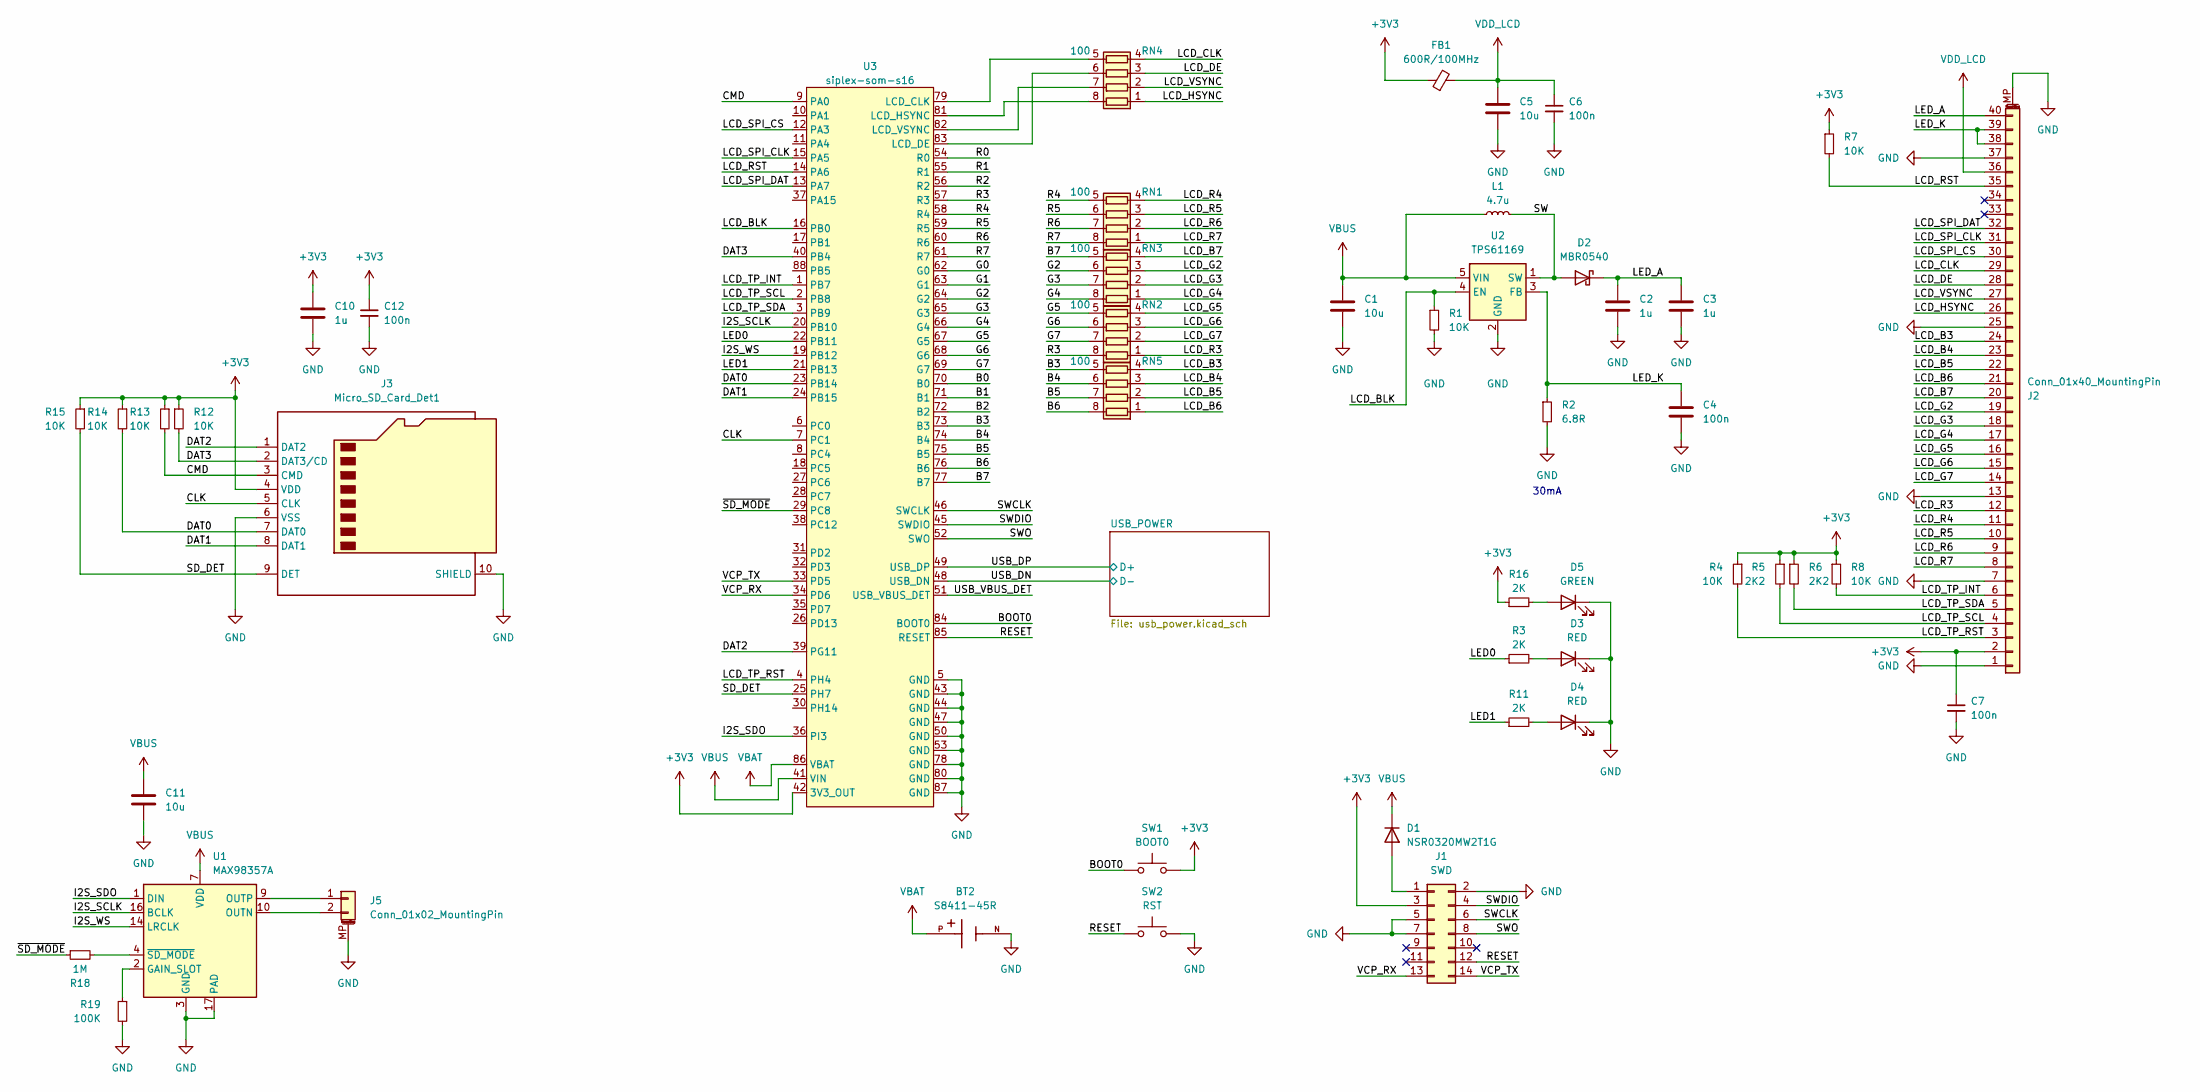
[picture p15: schematic lcd-square-4-4848.kicad_sch]

Parts:
BT2: S8411-45R; CR1220-Batt-conn-S8411-45R; JLCPCB Part # C70381
C1, C5, C11: 10u; C_0805_2012Metric; JLCPCB Part # C15850
C2, C3, C10: 1u; C_0603_1608Metric; JLCPCB Part # C15849
C4, C6, C7, C12: 100n; C_0402_1005Metric; JLCPCB Part # C307331
D1: NSR0320MW2T1G; D_SOD-123; JLCPCB Part # C48192
D2: MBR0540; D_SOD-123; JLCPCB Part # C7420330
D3, D4: RED; LED_0805_2012Metric; JLCPCB Part # C84256
D5: GREEN; LED_0805_2012Metric; JLCPCB Part # C2297
FB1: 600R/100MHz; C_0805_2012Metric; JLCPCB Part # C1017
J1: SWD; PinHeader_2x07_P1.27mm_Vertical_SMD; JLCPCB Part # C5160763C5160763
J2: Conn_01x40_MountingPin; Omron_XF2M-4015-1A_1x40-1MP_P0.5mm_Horizontal; JLCPCB Part # C225713
J3: Micro_SD_Card_Det1; SD-TF-115; JLCPCB Part # C266621
J5: Conn_01x02_MountingPin; Hirose_DF13C_CL535-0402-2-51_1x02-1MP_P1.25mm_Vertical; JLCPCB Part # C7419891
L1: 4.7u; L_Abracon_ASPI-4030S; JLCPCB Part # C57269
R1, R4, R7, R8, R12, R13, R14, R15: 10K; R_0402_1005Metric; JLCPCB Part # C25744
R2: 6.8R; R_0603_1608Metric; JLCPCB Part # C228038
R3, R11, R16: 2K; R_0402_1005Metric; JLCPCB Part # C4109
R5, R6: 2K2; R_0402_1005Metric; JLCPCB Part # C25879
R18: 1M; R_0402_1005Metric; JLCPCB Part # C26083
R19: 100K; R_0402_1005Metric; JLCPCB Part # C25741
RN1, RN2, RN3, RN4, RN5: 100; R_Array_Convex_4x0402; JLCPCB Part # C48442
SW1: BOOT0; SW_SPST_PTS810; JLCPCB Part # C127488
SW2: RST; SW_SPST_PTS810; JLCPCB Part # C127488
U1: MAX98357A; TQFN-16-1EP_3x3mm_P0.5mm_EP1.23x1.23mm; JLCPCB Part # C910544
U2: TPS61169; SOT-23-5; JLCPCB Part # C71045
U3: siplex-som-s16

Connections:
+3V3: C7.1, C10.1, C12.1, FB1.1, J1.3, J2.2, J3.4 (VDD), R4.1, R5.1, R6.1, R7.1, R8.1, R12.1, R13.1, R14.1, R15.1, R16.1, SW1.2, U3.42 (3V3_OUT)
/B0: U3.70 (B0)
/B1: U3.71 (B1)
/B2: U3.72 (B2)
/B3: RN5.5 (R4.2), U3.73 (B3)
/B4: RN5.6 (R3.2), U3.74 (B4)
/B5: RN5.7 (R2.2), U3.75 (B5)
/B6: RN5.8 (R1.2), U3.76 (B6)
/B7: RN3.5 (R4.2), U3.77 (B7)
/BOOT0: SW1.1, U3.84 (BOOT0)
/CLK: J3.5 (CLK), U3.7 (PC1)
/CMD: J3.3 (CMD), R13.2, U3.9 (PA0)
/DAT0: J3.7 (DAT0), R14.2, U3.23 (PB14)
/DAT1: J3.8 (DAT1), U3.24 (PB15)
/DAT2: J3.1 (DAT2), U3.39 (PG11)
/DAT3: J3.2 (DAT3/CD), R12.2, U3.40 (PB4)
/G0: U3.62 (G0)
/G1: U3.63 (G1)
/G2: RN3.6 (R3.2), U3.64 (G2)
/G3: RN3.7 (R2.2), U3.65 (G3)
/G4: RN3.8 (R1.2), U3.66 (G4)
/G5: RN2.5 (R4.2), U3.67 (G5)
/G6: RN2.6 (R3.2), U3.68 (G6)
/G7: RN2.7 (R2.2), U3.69 (G7)
/I2S_SCLK: U1.16 (BCLK), U3.20 (PB10)
/I2S_SDO: U1.1 (DIN), U3.36 (PI3)
/I2S_WS: U1.14 (LRCLK), U3.19 (PB12)
/LCD_B3: J2.24, RN5.4 (R4.1)
/LCD_B4: J2.23, RN5.3 (R3.1)
/LCD_B5: J2.22, RN5.2 (R2.1)
/LCD_B6: J2.21, RN5.1 (R1.1)
/LCD_B7: J2.20, RN3.4 (R4.1)
/LCD_BLK: R1.1, U2.4 (EN), U3.16 (PB0)
/LCD_CLK: J2.29, RN4.4 (R4.1)
/LCD_DE: J2.28, RN4.3 (R3.1)
/LCD_G2: J2.19, RN3.3 (R3.1)
/LCD_G3: J2.18, RN3.2 (R2.1)
/LCD_G4: J2.17, RN3.1 (R1.1)
/LCD_G5: J2.16, RN2.4 (R4.1)
/LCD_G6: J2.15, RN2.3 (R3.1)
/LCD_G7: J2.14, RN2.2 (R2.1)
/LCD_HSYNC: J2.26, RN4.1 (R1.1)
/LCD_R3: J2.12, RN2.1 (R1.1)
/LCD_R4: J2.11, RN1.4 (R4.1)
/LCD_R5: J2.10, RN1.3 (R3.1)
/LCD_R6: J2.9, RN1.2 (R2.1)
/LCD_R7: J2.8, RN1.1 (R1.1)
/LCD_RST: J2.35, R7.2, U3.14 (PA6)
/LCD_SPI_CLK: J2.31, U3.15 (PA5)
/LCD_SPI_CS: J2.30, U3.12 (PA3)
/LCD_SPI_DAT: J2.32, U3.13 (PA7)
/LCD_TP_INT: J2.6, R8.2, U3.1 (PB7)
/LCD_TP_RST: J2.3, R4.2, U3.4 (PH4)
/LCD_TP_SCL: J2.4, R5.2, U3.2 (PB8)
/LCD_TP_SDA: J2.5, R6.2, U3.3 (PB9)
/LCD_VSYNC: J2.27, RN4.2 (R2.1)
/LED0: R3.1, U3.22 (PB11)
/LED1: R11.1, U3.21 (PB13)
/LED_A: C2.1, C3.1, D2.1 (K), J2.40
/LED_K: C4.1, J2.38, J2.39, R2.1, U2.3 (FB)
/R0: U3.54 (R0)
/R1: U3.55 (R1)
/R2: U3.56 (R2)
/R3: RN2.8 (R1.2), U3.57 (R3)
/R4: RN1.5 (R4.2), U3.58 (R4)
/R5: RN1.6 (R3.2), U3.59 (R5)
/R6: RN1.7 (R2.2), U3.60 (R6)
/R7: RN1.8 (R1.2), U3.61 (R7)
/RESET: J1.12, SW2.1, U3.85 (RESET)
/SD_DET: J3.9 (DET), R15.2, U3.25 (PH7)
/SW: D2.2 (A), L1.2, U2.1 (SW)
/SWCLK: J1.6, U3.46 (SWCLK)
/SWDIO: J1.4, U3.45 (SWDIO)
/SWO: J1.8, U3.52 (SWO)
/USB_DN: U3.48 (USB_DN); also elsewhere on the board
/USB_DP: U3.49 (USB_DP); also elsewhere on the board
/USB_VBUS_DET: U3.51 (USB_VBUS_DET)
/VCP_RX: J1.13, U3.34 (PD6)
/VCP_TX: J1.14, U3.33 (PD5)
/~SD_MODE: R18.1, U3.29 (PC8)
GND: BT2.N, C1.2, C2.2, C3.2, C4.2, C5.2, C6.2, C7.2, C10.2, C11.2, C12.2, D3.1 (K), D4.1 (K), D5.1 (K), J1.2, J1.5, J1.7, J2.1, J2.7, J2.13, J2.25, J2.37, J2.MP (MountPin), J3.6 (VSS), J3.10 (SHIELD), J5.MP (MountPin), R1.2, R2.2, R19.2, SW2.2, U1.3 (GND), U1.11 (GND), U1.15 (GND), U1.17 (PAD), U2.2 (GND), U3.5 (GND), U3.43 (GND), U3.44 (GND), U3.47 (GND), U3.50 (GND), U3.53 (GND), U3.78 (GND), U3.80 (GND), U3.87 (GND); also elsewhere on the board
unnamed: D1.2 (A), J1.1
unnamed: D3.2 (A), R3.2
unnamed: D4.2 (A), R11.2
unnamed: D5.2 (A), R16.2
unnamed: J5.1, U1.9 (OUTP)
unnamed: J5.2, U1.10 (OUTN)
unnamed: RN4.8 (R1.2), U3.81 (LCD_HSYNC)
unnamed: RN4.7 (R2.2), U3.82 (LCD_VSYNC)
unnamed: RN4.6 (R3.2), U3.83 (LCD_DE)
unnamed: RN4.5 (R4.2), U3.79 (LCD_CLK)
unnamed: R19.1, U1.2 (GAIN_SLOT)
unnamed: R18.2, U1.4 (~SD_MODE)
VBAT: BT2.P, U3.86 (VBAT)
VBUS: C1.1, C11.1, D1.1 (K), L1.1, U1.7 (VDD), U1.8 (VDD), U2.5 (VIN), U3.41 (VIN); also elsewhere on the board
VDD_LCD: C5.1, C6.1, FB1.2, J2.36

Notes on the sheet:
30mA

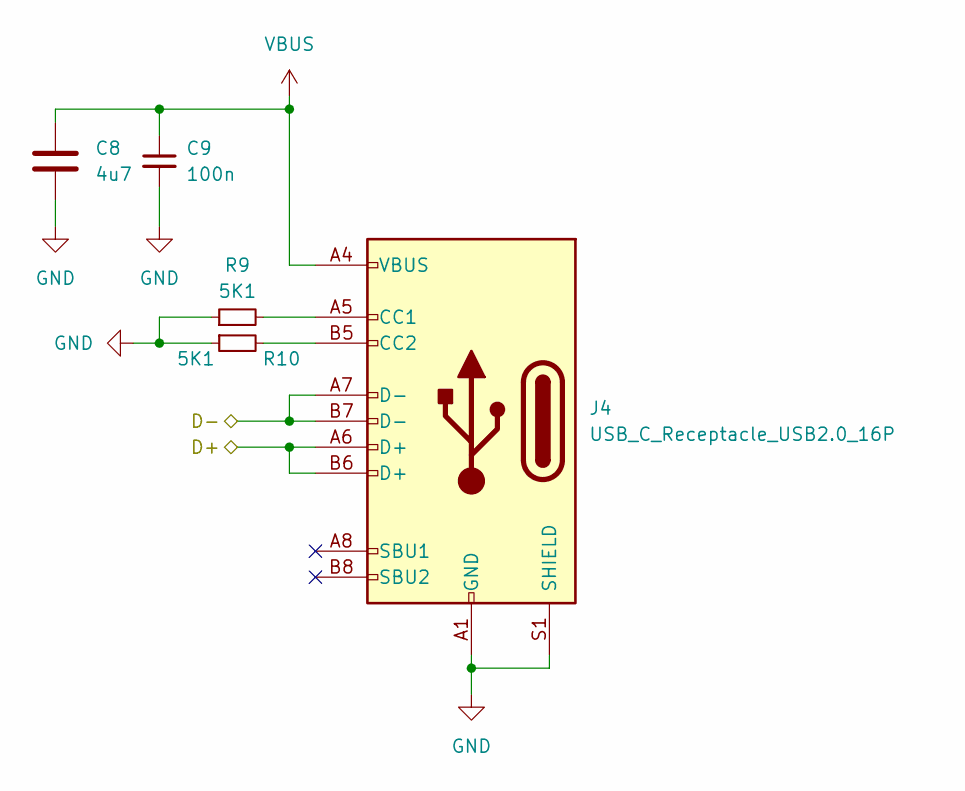
[picture p16: schematic usb_power.kicad_sch]

Parts:
C8: 4u7; C_0805_2012Metric; JLCPCB Part # C1779
C9: 100n; C_0402_1005Metric; JLCPCB Part # C307331
J4: USB_C_Receptacle_USB2.0_16P; USB_C_Receptacle_G-Switch_GT-USB-7010ASV; JLCPCB Part # C963412
R9, R10: 5K1; R_0402_1005Metric; JLCPCB Part # C25905

Connections:
/USB_DN: J4.A7 (D-), J4.B7 (D-); also elsewhere on the board
/USB_DP: J4.A6 (D+), J4.B6 (D+); also elsewhere on the board
GND: C8.2, C9.2, J4.A1 (GND), J4.A12 (GND), J4.B1 (GND), J4.B12 (GND), J4.S1 (SHIELD), R9.1, R10.1; also elsewhere on the board
unnamed: J4.A5 (CC1), R9.2
unnamed: J4.B5 (CC2), R10.2
VBUS: C8.1, C9.1, J4.A4 (VBUS), J4.A9 (VBUS), J4.B4 (VBUS), J4.B9 (VBUS); also elsewhere on the board

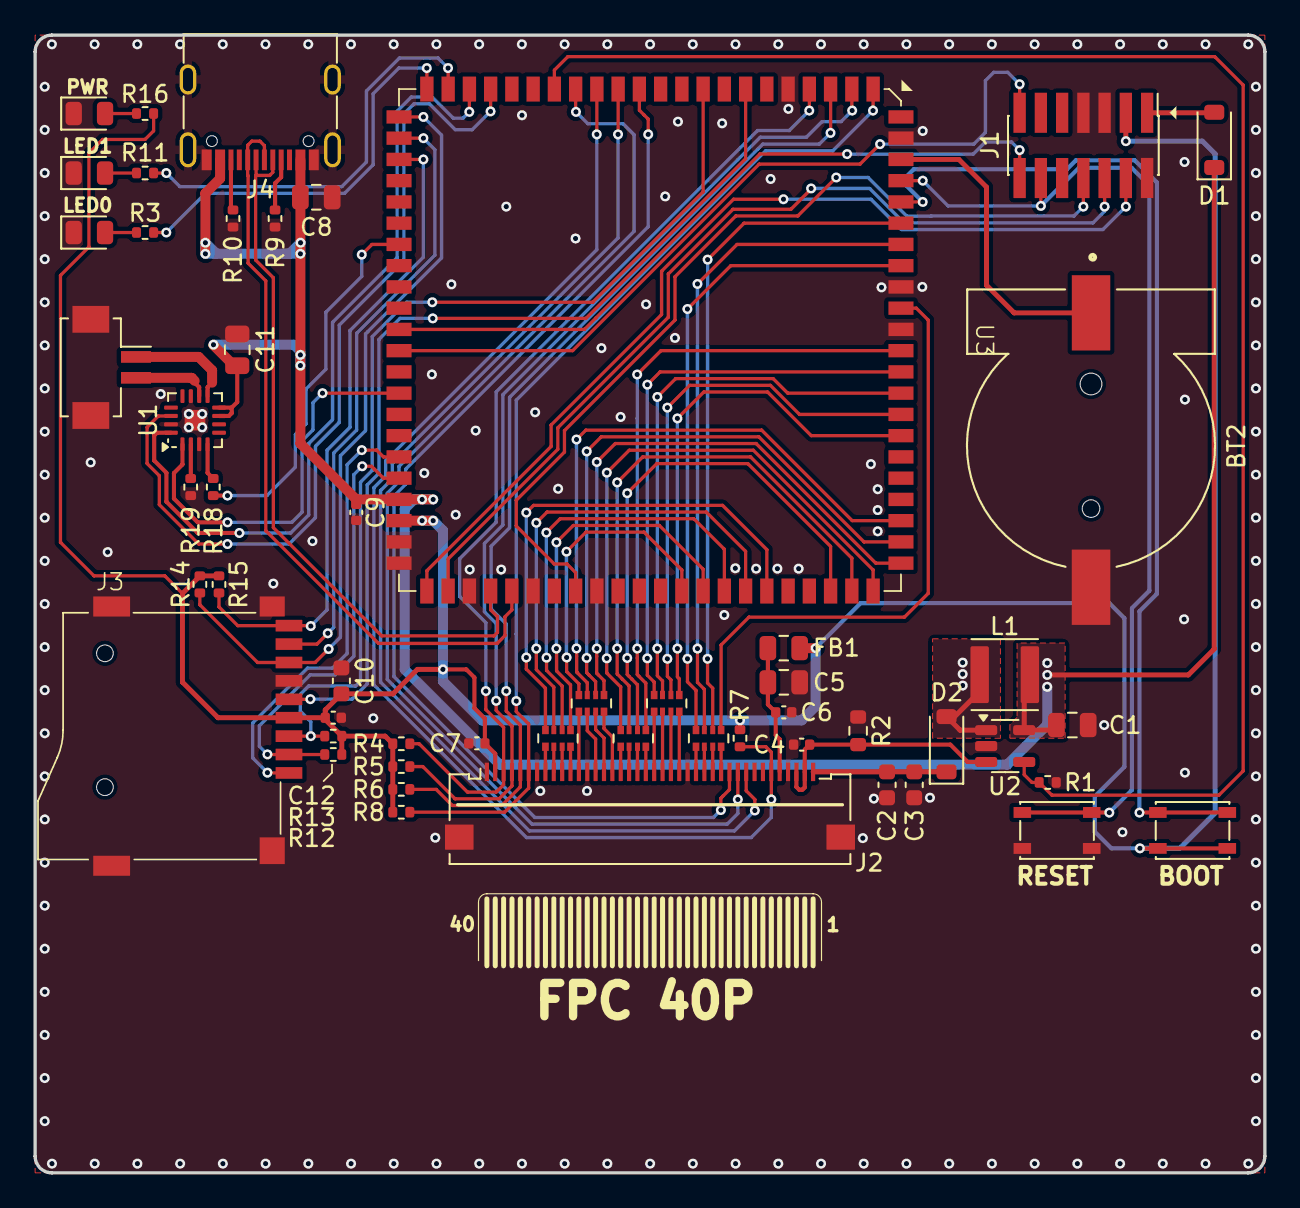
[picture p17: board lcd-square-4-4848.kicad_pcb from above]

Board: 2 copper layers, 73.5 x 68.0 mm, 53 parts (0 on the bottom side), 89 nets.
