rohamid/lcd-east-rising-backpack/lcd-standard-7R-8048/lcd-standard-7R-8048.kicad_pcb

## KiCad design lcd-standard-7R-8048/lcd-standard-7R-8048.kicad_pcb (2024-10-07)

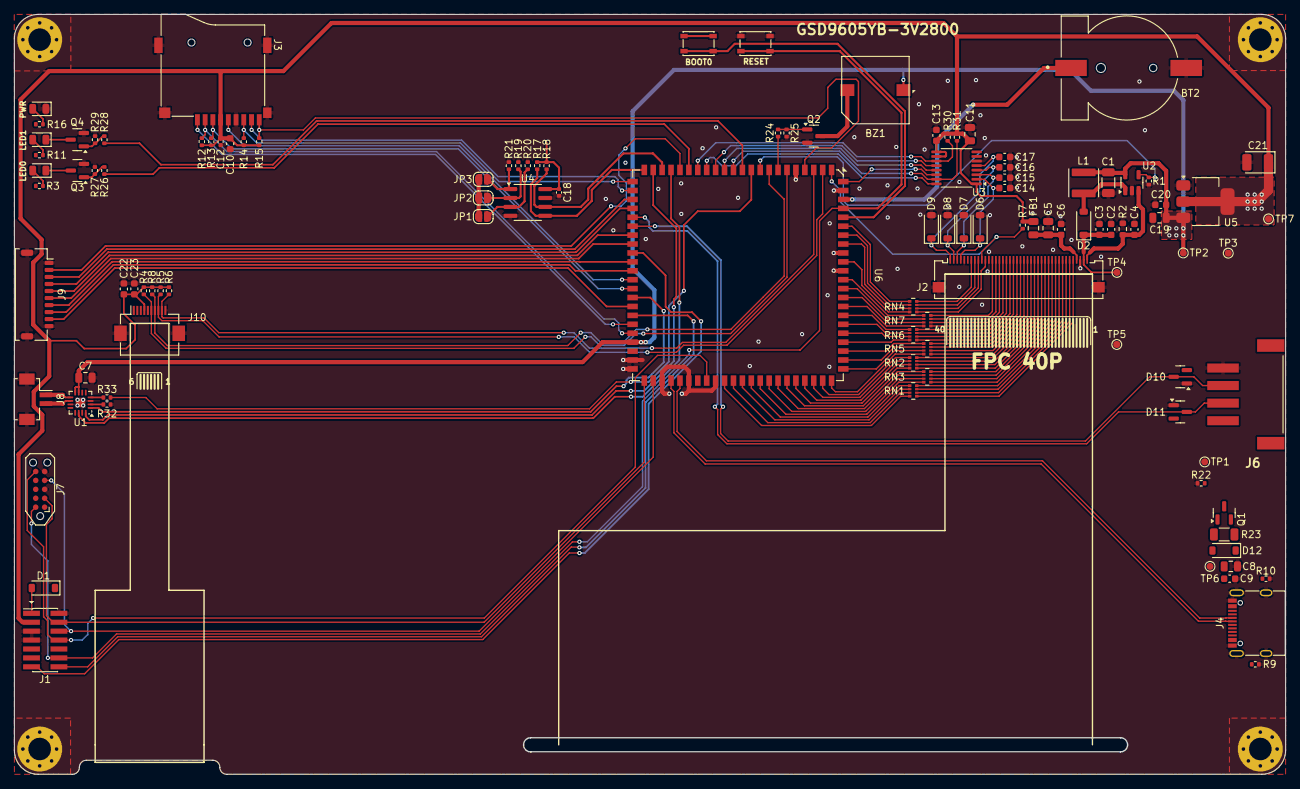
[picture p18: board lcd-standard-7R-8048.kicad_pcb from above]

Board: 2 copper layers, 181.0 x 108.2 mm, 114 parts (0 on the bottom side), 136 nets.

Parts:
BT2: S8411-45R; CR1220-Batt-conn-S8411-45R
BZ1: MLT-9650; active-MLT-9650
C1: 10u; C_1206_3216Metric
C2, C3, C10, C22: 1u; C_0603_1608Metric
C4, C6, C9, C13, C14, C15, C16, C17, C20, C23: 100n; C_0603_1608Metric
C5, C7, C11, C19: 10u; C_0805_2012Metric
C8: 4u7; C_0805_2012Metric
C12, C18: 100n; C_0402_1005Metric
C21: 22uF; CP_EIA-3528-12_Kemet-T
D1: NSR0320MW2T1G; D_SOD-123
D2, D12: MBR0540; D_SOD-123
D3, D4, D5: LED; LED_0805_2012Metric
D6, D7, D8, D9: MMSZ5226BT1G; D_SOD-123
D10, D11: BAT54S; SOT-23
FB1: 600R/100MHz; C_0805_2012Metric
H1, H2, H3, H4: MountingHole_Pad; MountingHole_3.2mm_M3_Pad_Via
J1: SWD; PinHeader_2x07_P1.27mm_Vertical_SMD
J2: Conn_01x40_MountingPin; Omron_XF2M-4015-1A_1x40-1MP_P0.5mm_Horizontal
J3: Micro_SD_Card_Det1; SD-TF-115
J4: USB_C_Receptacle_USB2.0_16P; USB_C_Receptacle_G-Switch_GT-USB-7010ASV
J6: Serial; S4BXHSM4TBLFSN
J7: Conn_ARM_JTAG_SWD_10; Tag-Connect_TC2050-IDC-NL_2x05_P1.27mm_Vertical
J8: Conn_01x02_MountingPin; Hirose_DF13C_CL535-0402-2-51_1x02-1MP_P1.25mm_Vertical
J9: Conn_01x10_MountingPin; JST_SHL_SM10B-SHLS-TF_1x10-1MP_P1.00mm_Horizontal
J10: Conn_01x10_MountingPin; Hirose_FH12-10S-0.5SH_1x10-1MP_P0.50mm_Horizontal
JP1, JP2, JP3: JMP; SolderJumper-2_P1.3mm_Open_RoundedPad1.0x1.5mm
L1: 6.8u; L_Abracon_ASPI-4030S
Q1: DMG2301L; SOT-23
Q2, Q3, Q4: MMBT3904; SOT-23
R1, R4, R7, R8, R12, R13, R14, R15, R22, R25, R27, R29, R30, R31: 10K; R_0402_1005Metric
R2: 4.7R; R_0603_1608Metric
R3, R11, R16: 2K; R_0402_1005Metric
R5, R6, R17, R18, R19, R20, R21: 2K2; R_0402_1005Metric
R9, R10: 5K1; R_0402_1005Metric
R23: 0; R_1206_3216Metric
R24, R26, R28: 1K; R_0402_1005Metric
R32: 100K; R_0402_1005Metric
R33: 1M; R_0402_1005Metric
RN1, RN2, RN3, RN4, RN5, RN6, RN7: 100; R_Array_Convex_4x0402
SW1: BOOT0; SW_SPST_PTS810
SW2: RST; SW_SPST_PTS810
TP1, TP2, TP3, TP4, TP5, TP6, TP7: TestPoint; TestPoint_Pad_D1.0mm
U1: MAX98357A; TQFN-16-1EP_3x3mm_P0.5mm_EP1.23x1.23mm
U2: TPS61169; SOT-23-5
U3: XPT2046TS; TSSOP-16_4.4x5mm_P0.65mm
U4: CAT24C256; SOIC-8_3.9x4.9mm_P1.27mm
U5: AMS1117-3.3; SOT-223-3_TabPin2
U6: siplex-som-s16

Connections:
+3V3: C10.1, C11.1, C12.1, C13.1, C18.1, C21.1, C22.1, C23.1, D10.2 (K), D11.2 (K), FB1.1, J1.3, J3.4 (VDD), J10.4, JP1.2 (B), JP2.2 (B), JP3.2 (B), R3.2, R4.2, R5.1, R6.1, R7.1, R8.2, R11.2, R12.1, R13.1, R14.1, R15.1, R16.1, R17.1, R18.1, R30.1, R31.1, SW1.2, TP7.1, U3.1 (VCC), U3.9 (VREF), U3.10 (IOVDD), U4.8 (VCC), U5.2 (VO)
/B0: RN6.8 (R1.2), U6.70 (B0)
/B1: RN6.7 (R2.2), U6.71 (B1)
/B2: RN6.6 (R3.2), U6.72 (B2)
/B3: RN6.5 (R4.2), U6.73 (B3)
/B4: RN7.8 (R1.2), U6.74 (B4)
/B5: RN7.7 (R2.2), U6.75 (B5)
/B6: RN7.6 (R3.2), U6.76 (B6)
/B7: RN7.5 (R4.2), U6.77 (B7)
/BOOT0: SW1.1, U6.84 (BOOT0)
/BUZZER: R24.1, U6.7 (PC1)
/CLK: J3.5 (CLK), U6.34 (PD6)
/CMD: J3.3 (CMD), R13.2, U6.35 (PD7)
/DAT0: J3.7 (DAT0), R14.2, U6.23 (PB14)
/DAT1: J3.8 (DAT1), U6.24 (PB15)
/DAT2: J3.1 (DAT2), U6.39 (PG11)
/DAT3: J3.2 (DAT3/CD), R12.2, U6.40 (PB4)
/DBG_RX: J1.13, U6.31 (PD2)
/DBG_TX: J1.14, U6.38 (PC12)
/EE_SCL: R18.2, U4.6 (SCL), U6.20 (PB10)
/EE_SDA: R17.2, U4.5 (SDA), U6.22 (PB11)
/G0: RN2.8 (R1.2), U6.62 (G0)
/G1: RN2.7 (R2.2), U6.63 (G1)
/G2: RN2.6 (R3.2), U6.64 (G2)
/G3: RN2.5 (R4.2), U6.65 (G3)
/G4: RN5.8 (R1.2), U6.66 (G4)
/G5: RN5.7 (R2.2), U6.67 (G5)
/G6: RN5.6 (R3.2), U6.68 (G6)
/G7: RN5.5 (R4.2), U6.69 (G7)
/GAIN_SLOT: R32.1, U1.2 (GAIN_SLOT)
/I2S2_CLK: U1.16 (BCLK), U6.21 (PB13)
/I2S2_SDO: U1.1 (DIN), U6.36 (PI3)
/I2S2_WS: U1.14 (LRCLK), U6.19 (PB12)
/IO_0: J9.9, U6.37 (PA15)
/IO_1: J9.8, U6.33 (PD5)
/IO_2: J9.7, U6.32 (PD3)
/IO_3: J9.6, U6.30 (PH14)
/IO_4: J9.5, U6.29 (PC8)
/IO_5: J9.4, U6.26 (PD13)
/IO_6: J9.3, U6.25 (PH7)
/IO_7: J9.2, U6.18 (PC5)
/LCD_B0: J2.20, RN6.1 (R1.1)
/LCD_B1: J2.19, RN6.2 (R2.1)
/LCD_B2: J2.18, RN6.3 (R3.1)
/LCD_B3: J2.17, RN6.4 (R4.1)
/LCD_B4: J2.16, RN7.1 (R1.1)
/LCD_B5: J2.15, RN7.2 (R2.1)
/LCD_B6: J2.14, RN7.3 (R3.1)
/LCD_B7: J2.13, RN7.4 (R4.1)
/LCD_BLK: R1.1, U2.4 (EN), U6.9 (PA0)
/LCD_CLK: J2.11, RN4.1 (R1.1)
/LCD_DE: J2.7, RN4.4 (R4.1)
/LCD_G0: J2.28, RN2.1 (R1.1)
/LCD_G1: J2.27, RN2.2 (R2.1)
/LCD_G2: J2.26, RN2.3 (R3.1)
/LCD_G3: J2.25, RN2.4 (R4.1)
/LCD_G4: J2.24, RN5.1 (R1.1)
/LCD_G5: J2.23, RN5.2 (R2.1)
/LCD_G6: J2.22, RN5.3 (R3.1)
/LCD_G7: J2.21, RN5.4 (R4.1)
/LCD_HSYNC: J2.9, RN4.2 (R2.1)
/LCD_R0: J2.36, RN1.1 (R1.1)
/LCD_R1: J2.35, RN1.2 (R2.1)
/LCD_R2: J2.34, RN1.3 (R3.1)
/LCD_R3: J2.33, RN1.4 (R4.1)
/LCD_R4: J2.32, RN3.1 (R1.1)
/LCD_R5: J2.31, RN3.2 (R2.1)
/LCD_R6: J2.30, RN3.3 (R3.1)
/LCD_R7: J2.29, RN3.4 (R4.1)
/LCD_RST: J2.10, R7.2, U6.1 (PB7)
/LCD_VSYNC: J2.8, RN4.3 (R3.1)
/LED0: R26.1, U6.17 (PB1)
/LED1: R28.1, U6.11 (PA4)
/LED_A: C2.1, C3.1, D2.1 (K), J2.39, TP4.1
/LED_K: C4.1, J2.40, R2.1, U2.3 (FB)
/R1: RN1.7 (R2.2), U6.55 (R1)
/R2: RN1.6 (R3.2), U6.56 (R2)
/R3: RN1.5 (R4.2), U6.57 (R3)
/R4: RN3.8 (R1.2), U6.58 (R4)
/R5: RN3.7 (R2.2), U6.59 (R5)
/R6: RN3.6 (R3.2), U6.60 (R6)
/R7: RN3.5 (R4.2), U6.61 (R7)
/RESET: J1.12, J7.10 (~RESET), SW2.1, U6.85 (RESET)
/SD_DET: J3.9 (DET), R15.2, U6.4 (PH4)
/SERIAL_RX: D10.3 (COM), J6.3, U6.28 (PC7)
/SERIAL_TX: D11.3 (COM), J6.2, U6.27 (PC6)
/SW: D2.2 (A), L1.2, U2.1 (SW)
/SWCLK: J1.6, J7.4 (SWCLK/TCK), U6.46 (SWCLK)
/SWDIO: J1.4, J7.2 (SWDIO/TMS), U6.45 (SWDIO)
/SWO: J1.8, J7.6 (SWO/TDO), U6.52 (SWO)
/TP_BUSY: U3.13 (BUSY), U6.13 (PA7)
/TP_CLK: U3.16 (DCLK), U6.15 (PA5)
/TP_CS: R31.2, U3.15 (~CS), U6.12 (PA3)
/TP_INT: J10.6, R4.1, U6.6 (PC0)
/TP_IRQ: R30.2, U3.11 (~PENIRQ), U6.16 (PB0)
/TP_MISO: U3.12 (DOUT), U6.14 (PA6)
/TP_MOSI: U3.14 (DIN), U6.88 (PB5)
/TP_SCL: J10.8, R5.2, U6.2 (PB8)
/TP_SDA: J10.9, R6.2, U6.3 (PB9)
/TP_WAKE: J10.7, R8.1, U6.8 (PC4)
/USB_DN: J4.A7 (D-), J4.B7 (D-), U6.48 (USB_DN)
/USB_DP: J4.A6 (D+), J4.B6 (D+), U6.49 (USB_DP)
/XL: C16.1, D8.1 (K), J2.2, U3.4 (XN)
/XR: C14.1, D6.1 (K), J2.4, U3.2 (XP)
/YD: C15.1, D7.1 (K), J2.3, U3.3 (YP)
/YU: C17.1, D9.1 (K), J2.1, U3.5 (YN)
/~SD_MODE: R33.2, U6.10 (PA1)
GND: BT2.N, C1.2, C2.2, C3.2, C4.2, C5.2, C6.2, C7.2, C8.2, C9.2, C10.2, C11.2, C12.2, C13.2, C14.2, C15.2, C16.2, C17.2, C18.2, C19.2, C20.2, C21.2, C22.2, C23.2, D5.1 (K), D6.2 (A), D7.2 (A), D8.2 (A), D9.2 (A), D10.1 (A), D11.1 (A), H1.1, H2.1, H3.1, H4.1, J1.2, J1.5, J1.7, J2.5, J2.12, J2.38, J2.MP (MountPin), J3.6 (VSS), J3.10 (SHIELD), J4.A1 (GND), J4.A12 (GND), J4.B1 (GND), J4.B12 (GND), J4.S1 (SHIELD), J6.4, J7.3 (GND), J7.5 (GND), J8.MP (MountPin), J9.1, J9.10, J9.MP (MountPin), J10.10, J10.MP (MountPin), Q2.2 (E), Q3.2 (E), Q4.2 (E), R1.2, R2.2, R9.1, R10.1, R19.2, R20.2, R21.2, R22.2, R25.2, R27.2, R29.2, R32.2, SW2.2, TP3.1, TP5.1, U1.3 (GND), U1.11 (GND), U1.15 (GND), U1.17 (PAD), U2.2 (GND), U3.6 (GND), U4.4 (GND), U4.7 (WP), U5.1 (GND), U6.5 (GND), U6.43 (GND), U6.44 (GND), U6.47 (GND), U6.50 (GND), U6.53 (GND), U6.78 (GND), U6.80 (GND), U6.87 (GND)
unnamed: BZ1.2 (-), Q2.3 (C)
unnamed: D1.2 (A), J1.1
unnamed: D3.2 (A), R3.1
unnamed: D3.1 (K), Q3.3 (C)
unnamed: D4.2 (A), R11.1
unnamed: D4.1 (K), Q4.3 (C)
unnamed: D5.2 (A), R16.2
unnamed: J4.A5 (CC1), R9.2
unnamed: J4.B5 (CC2), R10.2
unnamed: J8.1, U1.9 (OUTP)
unnamed: J8.2, U1.10 (OUTN)
unnamed: JP1.1 (A), R20.1, U4.3 (A2)
unnamed: JP2.1 (A), R19.1, U4.2 (A1)
unnamed: JP3.1 (A), R21.1, U4.1 (A0)
unnamed: Q2.1 (B), R24.2, R25.1
unnamed: Q3.1 (B), R26.2, R27.1
unnamed: Q4.1 (B), R28.2, R29.1
unnamed: RN1.8 (R1.2), U6.54 (R0)
unnamed: RN4.8 (R1.2), U6.79 (LCD_CLK)
unnamed: RN4.7 (R2.2), U6.81 (LCD_HSYNC)
unnamed: RN4.6 (R3.2), U6.82 (LCD_VSYNC)
unnamed: RN4.5 (R4.2), U6.83 (LCD_DE)
unnamed: R33.1, U1.4 (~SD_MODE)
VBAT: BT2.P, U6.86 (VBAT)
VBUS: C8.1, C9.1, J4.A4 (VBUS), J4.A9 (VBUS), J4.B4 (VBUS), J4.B9 (VBUS), Q1.3 (D), TP6.1
VDD: BZ1.1 (+), C1.1, C7.1, C19.1, C20.1, D1.1 (K), D12.1 (K), L1.1, Q1.2 (S), R23.2, TP2.1, U1.7 (VDD), U1.8 (VDD), U2.5 (VIN), U5.3 (VI), U6.41 (VIN)
VDD_LCD: C5.1, C6.1, FB1.2, J2.37
VEXT: D12.2 (A), J6.1, Q1.1 (G), R22.1, R23.1, TP1.1
