rohamid/lcd-east-rising-backpack/(commit log)

2024-09-16 Add LCD square 4-inch 480-480 & 720-720
    [lcd-bar-3_4.kicad_pcb, lcd-bar-3_4.kicad_sch, lcd-square-4-4848.kicad_pcb, lcd-square-4-4848.kicad_sch, lcd-square-4-7272.kicad_pcb, lcd-square-4-7272.kicad_sch, usb_power.kicad_sch]
2024-09-19 LCD 4inch 480-480 on progress
    [lcd-square-4-4848.kicad_pcb, lcd-square-4-4848.kicad_sch, usb_power.kicad_sch]
2024-09-19 Change SD card orientation
    [lcd-square-4-4848.kicad_pcb, lcd-square-4-4848.kicad_sch, usb_power.kicad_sch]
2024-09-20 Add standard 5inch and 7inch display both resistive and capacitive
    [lcd-square-4-4848.kicad_pcb, lcd-standard-5R.kicad_pcb, lcd-standard-5R.kicad_sch, lcd-standard-7-8048.kicad_pcb, lcd-standard-7-8048.kicad_sch, usb_power.kicad_sch]
2024-10-01 98% finished, st-link part left
    [lcd-bar-3_4.kicad_pcb, lcd-bar-3_4.kicad_sch]
2024-10-01 LCD 4inch 480x480 98% finished, st-link left
    [lcd-square-4-4848.kicad_pcb, lcd-square-4-4848.kicad_sch]
2024-10-02 Added Serial, Buzzer, AUX-IO, POWER switch, XPT2046, TAG-connect, EEPROM
    [lcd-standard-5R.kicad_pcb, lcd-standard-5R.kicad_sch, usb_power.kicad_sch]
2024-10-02 LCD 5 inch, Finished SD card, Touch, Buzzer etc, LCD Bar 3.4, Adding resistor on st-link, not finished yet
    [lcd-square-4-4848.kicad_sch, lcd-standard-5R.kicad_pcb, lcd-standard-5R.kicad_sch]
2024-10-03 Adding MAX98357 I2S mono Amplifier
    [lcd-standard-5R.kicad_pcb, lcd-standard-5R.kicad_sch]
2024-10-03 LCD 5inch, finished tracks, LCD square, Adding MAX98357A
    [lcd-square-4-4848.kicad_pcb, lcd-square-4-4848.kicad_sch, lcd-standard-5R.kicad_pcb]
2024-10-04 Add LCD standard 7inch
    [lcd-bar-3_4.kicad_pcb, lcd-bar-3_4.kicad_sch, lcd-square-4-4848.kicad_pcb, lcd-square-4-4848.kicad_sch, lcd-standard-5R.kicad_pcb, lcd-standard-5R.kicad_sch, lcd-standard-7R-8048.kicad_pcb, lcd-standard-7R-8048.kicad_sch]
2024-10-06 Layouting LCD 7R, LED's and PWR tracks left
    [lcd-standard-7R-8048.kicad_pcb, lcd-standard-7R-8048.kicad_sch]
2024-10-07 Added sd_det tracks
    [lcd-standard-5R.kicad_pcb, lcd-standard-5R.kicad_sch, lcd-standard-7R-8048.kicad_pcb]
2024-10-11 Slight changes
    [lcd-bar-3_4.kicad_pcb, lcd-bar-3_4.kicad_sch, lcd-square-4-4848.kicad_pcb, lcd-square-4-4848.kicad_sch, lcd-standard-5R.kicad_pcb, lcd-standard-5R.kicad_sch, usb_power.kicad_sch]
2024-10-13 Change LCD 5R to onboard MCU, cause separate boards are too expensive
    [24C256.kicad_sch, MAX98357.kicad_sch, QSPI_Flash.kicad_sch, SDRAM.kicad_sch, STM32H743ZITx.kicad_sch, W25Q512.kicad_sch, input-output.kicad_sch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]
2024-10-14 Change MCU to STM32H743
    [24C256.kicad_sch, MAX98357.kicad_sch, SDRAM.kicad_sch, STM32H743ZITx.kicad_sch, input-output.kicad_sch, lcd-standard-5R.kicad_pcb, lcd-standard-5R.kicad_sch, lcd_display_40p.kicad_sch]
2024-10-14 Add 10P FPC for 5-inch Tailor pixel CTP
    [lcd-standard-5R.kicad_pcb, lcd_display_40p.kicad_sch, usb_power.kicad_sch]
2024-10-15 Change 10P CTP to omron type
    [24C256.kicad_sch, lcd-standard-5R.kicad_pcb, lcd_display_40p.kicad_sch, uSD_Card.kicad_sch, usb_power.kicad_sch]
2024-10-16 Change pinout to the optimum usage
    [STM32H743ZITx.kicad_sch, lcd-standard-5R.kicad_sch]
2024-10-17 Finished SDRAM, LCD (need checkup with CubeIDE), RTP touch controll
    [24C256.kicad_sch, STM32H743ZITx.kicad_sch, lcd-standard-5R.kicad_pcb, lcd-standard-5R.kicad_sch, lcd_display_40p.kicad_sch, uSD_Card.kicad_sch]
2024-10-18 Finsihed, need to touch up a bit
    [STM32H743ZITx.kicad_sch, input-output.kicad_sch, lcd-standard-5R.kicad_pcb, lcd-standard-5R.kicad_sch]
2024-10-19 Adding filter on MAX98357, TODO: Add more grounding vias
    [MAX98357.kicad_sch, input-output.kicad_sch, lcd-standard-5R.kicad_pcb, lcd-standard-5R.kicad_sch, lcd_display_40p.kicad_sch]
2024-11-26 Added 3.4inch bar LCD to the dimension
    [lcd-standard-5R-B_Cu.gbr, lcd-standard-5R-B_Mask.gbr, lcd-standard-5R-B_Paste.gbr, lcd-standard-5R-B_Silkscreen.gbr, lcd-standard-5R-Edge_Cuts.gbr, lcd-standard-5R-F_Cu.gbr, lcd-standard-5R-F_Mask.gbr, lcd-standard-5R-F_Paste.gbr]
2025-01-03 Rebuild 4inch LCD with non SOM
    [24C256.kicad_sch, IS42S16160.kicad_sch, IS42S16160J-7TL.kicad_sch, LCD-ST77xx-standard.kicad_sch, STM32H743IITx.kicad_sch, W25Q512.kicad_sch, lcd-square-4-4848.kicad_pcb, lcd-square-4-7272.kicad_pcb]
2025-02-27 Add pinout for 5inch LCD Module
    [pinout-pin.xlsx]
2025-04-16 Add QSPI Flash trace length matching to 5 inch LCD
    [24C256.kicad_sch, IS42S16160J-7TL.kicad_sch, MAX98357.kicad_sch, SDRAM.kicad_sch, STM32H743IITx.kicad_sch, STM32H743ZITx.kicad_sch, W25Q512.kicad_sch, input-output.kicad_sch]
